ledangaravi/sync-module/CV/images/80.png

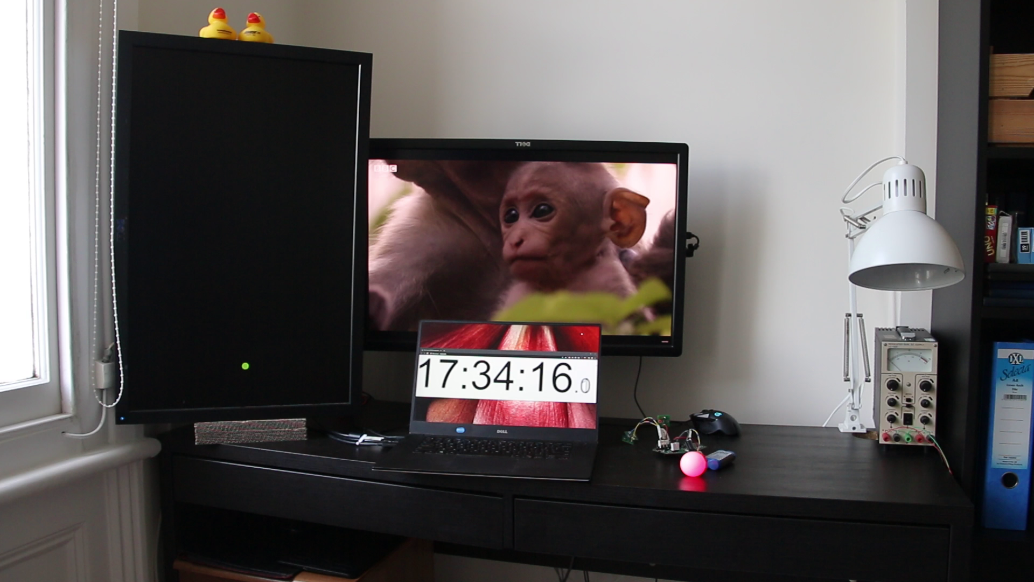
CV/images/80.png
