ledangaravi/sync-module/CV/images/keypoints.png

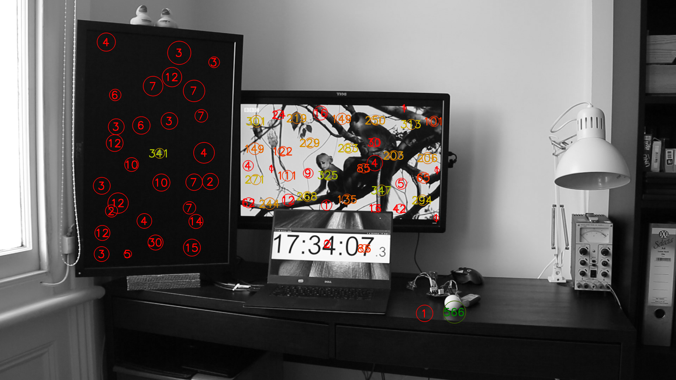
CV/images/keypoints.png
