ledangaravi/sync-module/README.md

# sync-module
Synchronisation Module for the NGNI Spike Sorting Platform
