ledangaravi/sync-module/CV/morph_demo/closeopen.png

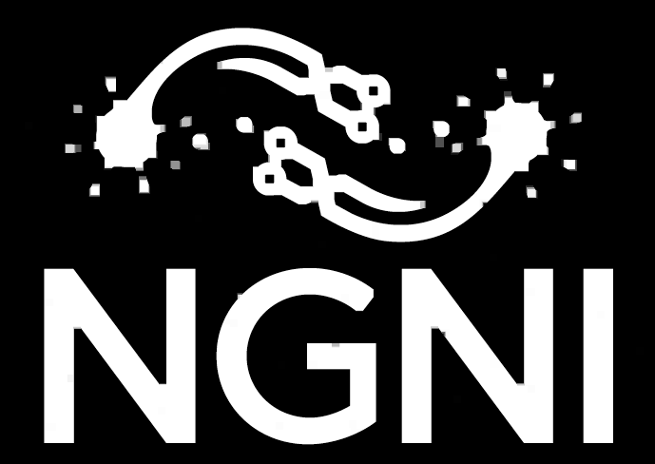
CV/morph_demo/closeopen.png
