ledangaravi/sync-module/CV/morph_demo/closing1.png

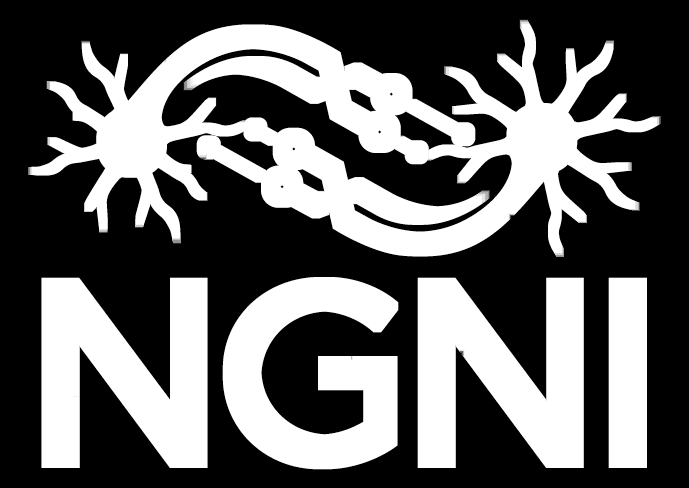
CV/morph_demo/closing1.png
