ledangaravi/sync-module/CV/morph_demo/closing2.png

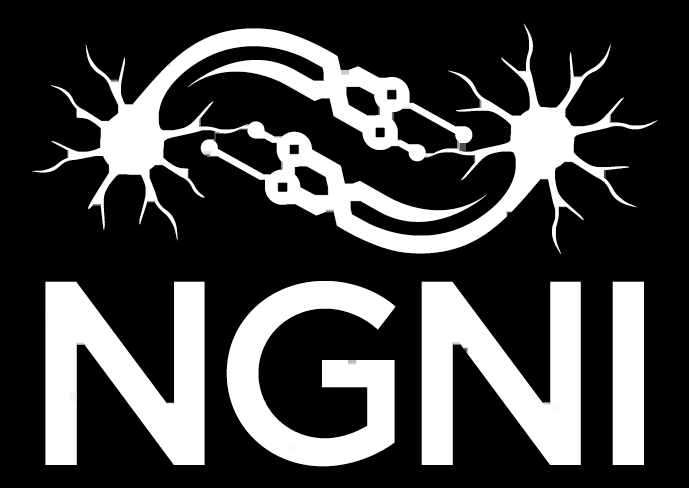
CV/morph_demo/closing2.png
