ledangaravi/sync-module/CV/morph_demo/erosion.png

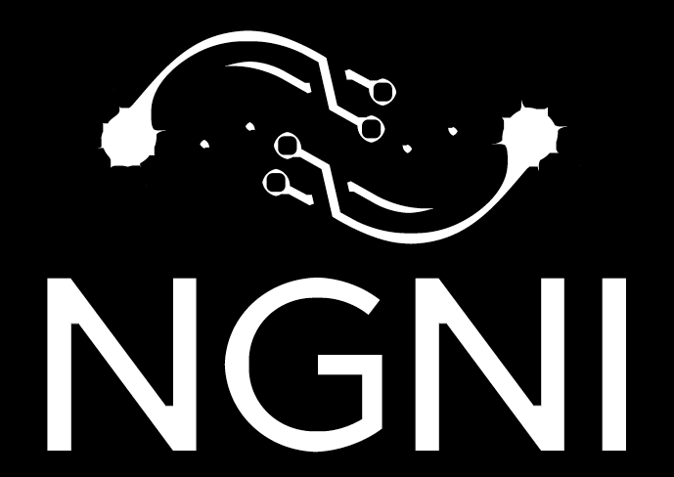
CV/morph_demo/erosion.png
