ledangaravi/sync-module/beacon_enclosure/case.stl

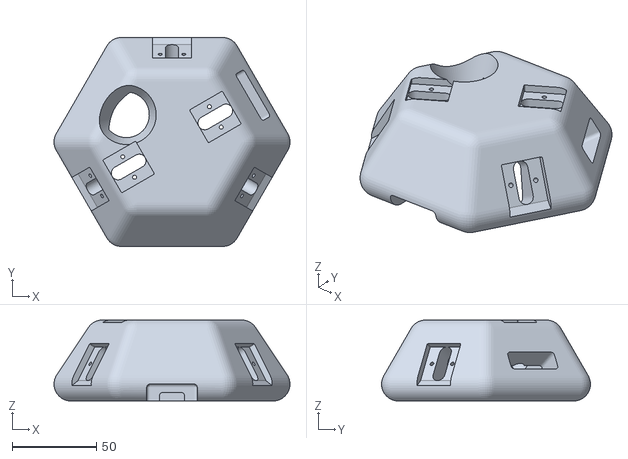
[picture p7: CAD file, 2020-06-19]
beacon_enclosure/case.stl
139.9 x 123.9 x 48.0
