ledangaravi/sync-module/PCB/KiCad_Library/my_library/3D_models/USB_C_Receptacle_HIROSE_CX90M-16P.stp

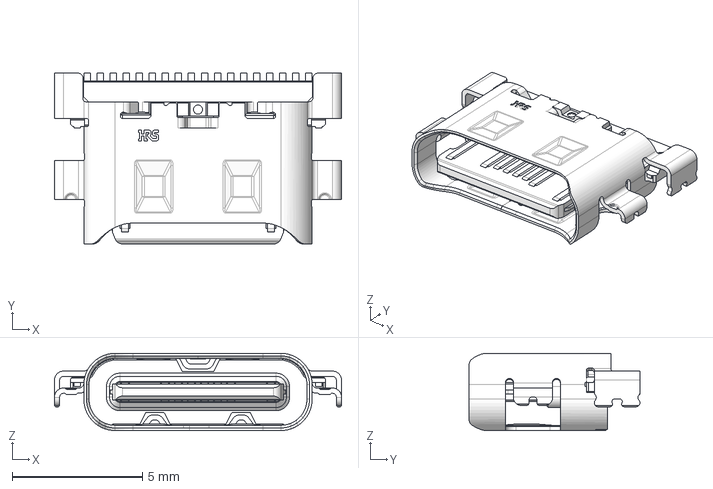
[picture p8: CAD file, 2020-06-19]
PCB/KiCad_Library/my_library/3D_models/USB_C_Receptacle_HIROSE_CX90M-16P.stp
11.0 x 6.55 x 2.97 mm
