ledangaravi/sync-module/Testing/power_consumption/battery_life_cam_max.pdf

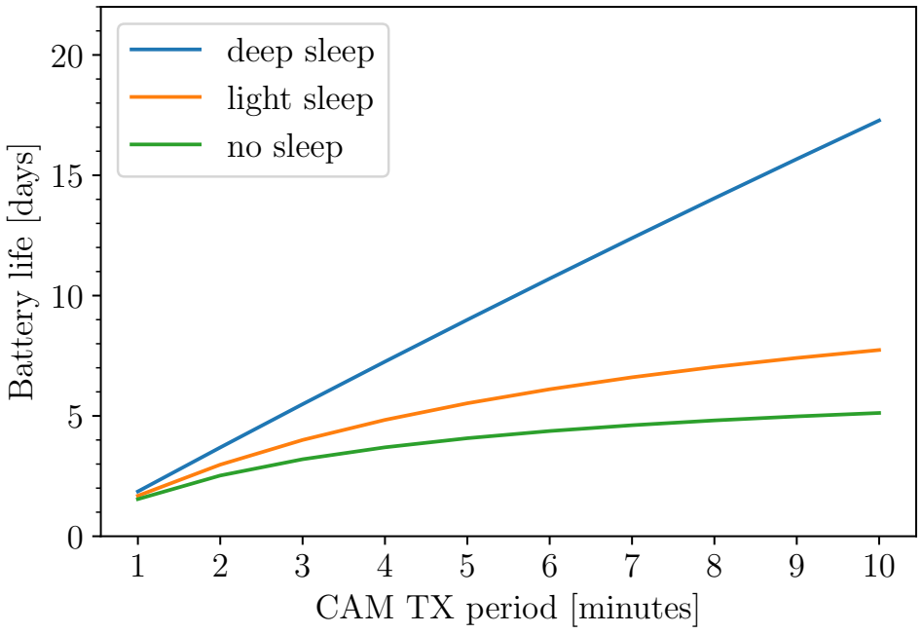
[picture p9: figure]
CAM TX period [minutes]; Battery life [days]; deep sleep light sleep no sleep
