ledangaravi/sync-module/Testing/power_consumption/battery_life_cam_mid.pdf

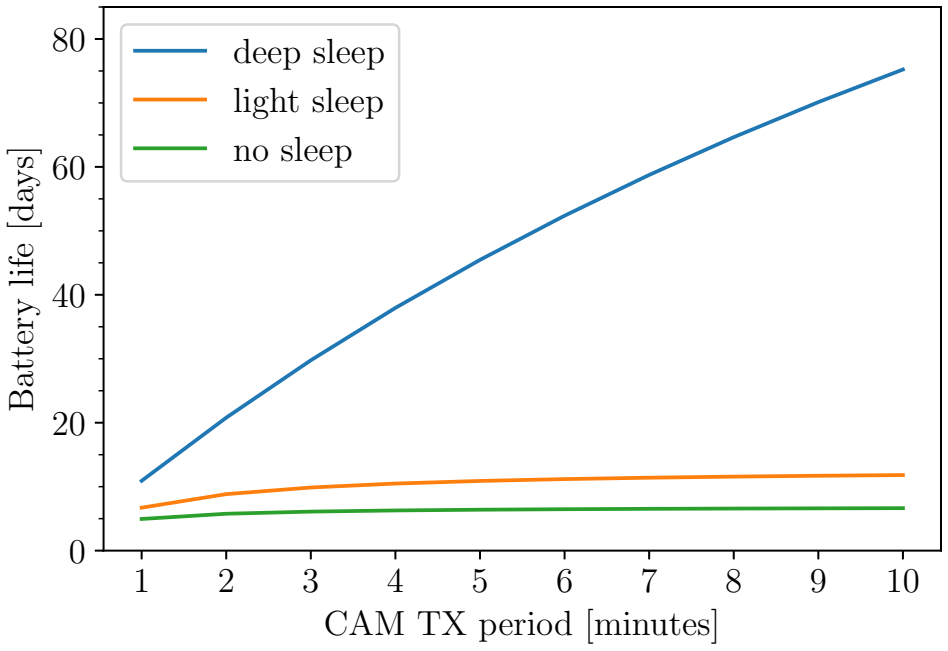
[picture p10: figure]
CAM TX period [minutes]; Battery life [days]; deep sleep light sleep no sleep
