ledangaravi/sync-module/Testing/webench/lm3478.pdf

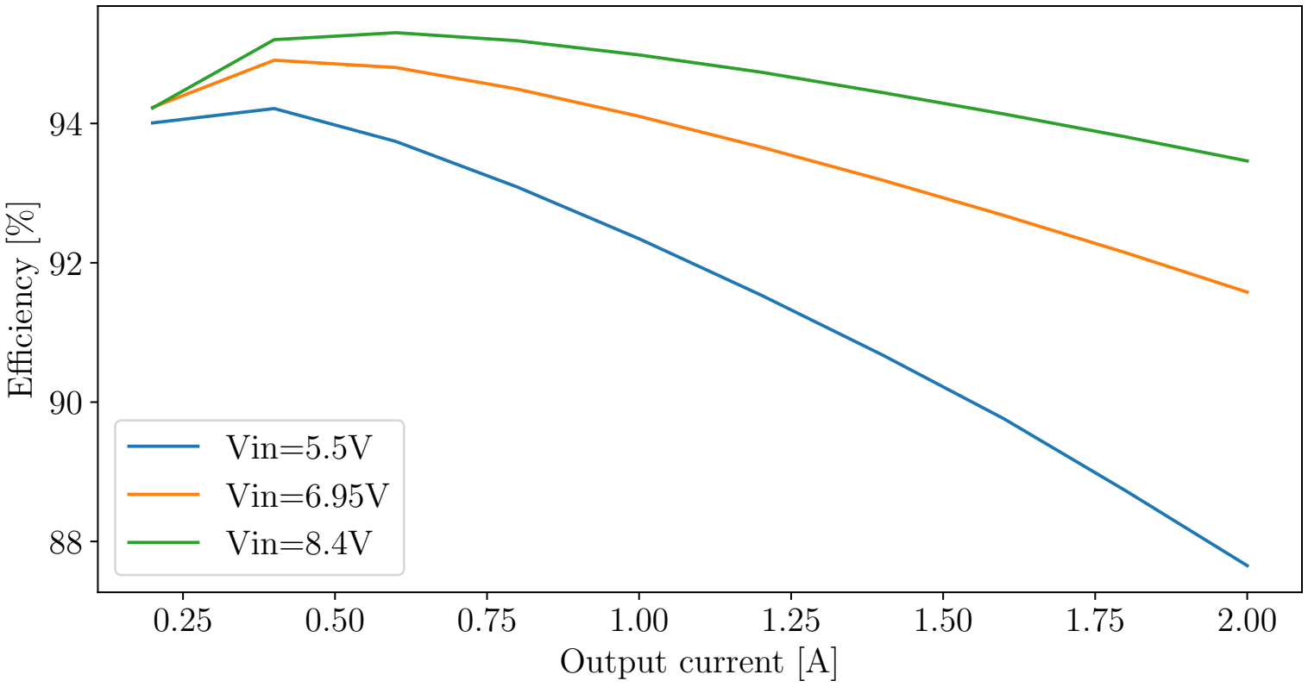
[picture p11: figure]
Output current [A]; Efficiency [%]; Vin=5.5V Vin=6.95V Vin=8.4V
