ledangaravi/sync-module/Testing/webench/lm3478.csv

Output Current | Vin=5.5V | Vin=6.95V | Vin=8.4V
0.2 | 94.008 | 94.231 | 94.222
0.4 | 94.214 | 94.908 | 95.203
0.6000000000000001 | 93.742 | 94.803 | 95.303
0.8 | 93.087 | 94.493 | 95.187
1 | 92.345 | 94.103 | 94.984
1.2 | 91.539 | 93.662 | 94.737
1.4 | 90.678 | 93.187 | 94.444
1.5999999999999999 | 89.761 | 92.68 | 94.136
1.7999999999999998 | 88.729 | 92.145 | 93.808
1.9999999999999998 | 87.653 | 91.579 | 93.462
