ledangaravi/sync-module/Testing/power_consumption/led_energy.pdf

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

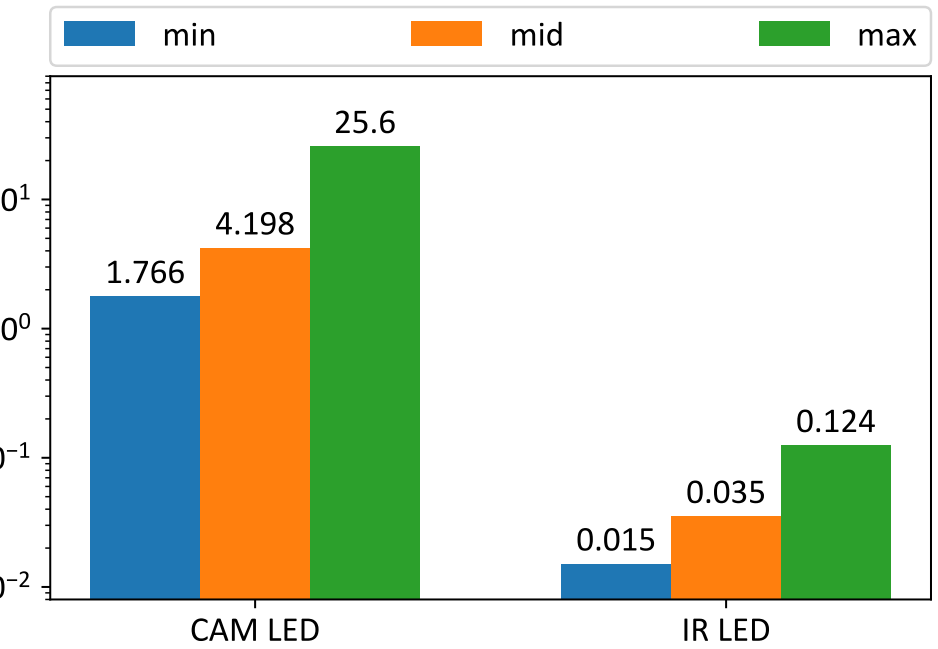
[picture p12: figure]
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
