ledangaravi/sync-module/Testing/webench/tlv62130.csv

Output Current | Vin=5.5V | Vin=6.95V | Vin=8.4V
0.001 | 87.709 | 86.236 | 84.455
0.0015 | 88.688 | 87.406 | 85.792
0.002 | 89.186 | 88.003 | 86.476
0.0025 | 89.487 | 88.365 | 86.892
0.003 | 89.689 | 88.608 | 87.171
0.0035 | 89.833 | 88.782 | 87.371
0.004 | 89.942 | 88.913 | 87.522
0.0045 | 90.027 | 89.015 | 87.64
0.005 | 90.095 | 89.097 | 87.734
0.0055 | 90.15 | 89.164 | 87.812
0.006 | 90.196 | 89.22 | 87.876
0.0065 | 90.235 | 89.267 | 87.931
0.007 | 90.269 | 89.308 | 87.978
0.0075 | 90.298 | 89.343 | 88.018
0.008 | 90.323 | 89.374 | 88.054
0.0085 | 90.346 | 89.401 | 88.085
0.009 | 90.365 | 89.425 | 88.113
0.0095 | 90.383 | 89.446 | 88.138
0.01 | 90.399 | 89.466 | 88.16
0.015 | 90.499 | 89.588 | 88.302
0.02 | 90.547 | 89.648 | 88.371
0.025 | 90.575 | 89.683 | 88.412
0.03 | 90.593 | 89.705 | 88.439
0.035 | 90.604 | 89.72 | 88.457
0.04 | 90.612 | 89.731 | 88.471
0.045 | 90.618 | 89.739 | 88.48
0.05 | 90.621 | 89.745 | 88.488
0.055 | 90.624 | 89.75 | 88.493
0.06 | 90.625 | 89.753 | 88.497
0.065 | 90.626 | 89.755 | 88.501
0.07 | 90.626 | 89.757 | 88.503
0.075 | 90.626 | 89.758 | 88.505
0.08 | 90.626 | 89.758 | 88.506
0.085 | 90.625 | 89.759 | 88.507
0.09 | 90.624 | 89.759 | 88.508
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
