ledangaravi/sync-module/Testing/power_consumption/data/8V/1 - ir led max (0.5ohm)/F0001CH1.CSV

Record Length | 2.500000e+03 | -0.005000000000 | 0.00800
Sample Interval | 4.000000e-06 | -0.004996000000 | 0.00800
Trigger Point | 1.250000000000e+03 | -0.004992000000 | 0.00800
 |  | -0.004988000000 | 0.00800
 |  | -0.004984000000 | 0.00800
 |  | -0.004980000000 | 0.00000
Source | CH1 | -0.004976000000 | 0.00800
Vertical Units | V | -0.004972000000 | 0.00800
Vertical Scale | 2.000000e-01 | -0.004968000000 | 0.00800
Vertical Offset | -6.240000e-01 | -0.004964000000 | 0.01600
Horizontal Units | s | -0.004960000000 | 0.00800
Horizontal Scale | 1.000000e-03 | -0.004956000000 | 0.01600
Pt Fmt | Y | -0.004952000000 | 0.00800
Yzero | 0.000000e+00 | -0.004948000000 | 0.00800
Probe Atten | 1.000000e+00 | -0.004944000000 | 0.00800
Model Number | TDS2012C | -0.004940000000 | 0.00800
Serial Number | C023721 | -0.004936000000 | 0.00800
Firmware Version | FV:v24.18 | -0.004932000000 | 0.00000
 |  | -00.004928000000 | 0.00800
 |  | -00.004924000000 | 0.00800
 |  | -00.004920000000 | 0.00800
 |  | -00.004916000000 | 0.01600
 |  | -00.004912000000 | 0.01600
 |  | -00.004908000000 | 0.01600
 |  | -00.004904000000 | 0.00800
 |  | -00.004900000000 | 0.00800
 |  | -00.004896000000 | 0.00800
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
