ledangaravi/sync-module/Testing/power_consumption/data/8V/2 - ir led mid (0.5ohm)/F0002CH1.CSV

Record Length | 2.500000e+03 | -0.025000000000 | 0.00800
Sample Interval | 2.000000e-05 | -0.024980000000 | 0.00800
Trigger Point | 1.250000000000e+03 | -0.024960000000 | 0.00800
 |  | -0.024940000000 | 0.00800
 |  | -0.024920000000 | 0.00800
 |  | -0.024900000000 | 0.00800
Source | CH1 | -0.024880000000 | 0.00800
Vertical Units | V | -0.024860000000 | 0.00800
Vertical Scale | 2.000000e-01 | -0.024840000000 | 0.00800
Vertical Offset | -6.240000e-01 | -0.024820000000 | 0.01600
Horizontal Units | s | -0.024800000000 | 0.00800
Horizontal Scale | 5.000000e-03 | -0.024780000000 | 0.01600
Pt Fmt | Y | -0.024760000000 | 0.00800
Yzero | 0.000000e+00 | -0.024740000000 | 0.00800
Probe Atten | 1.000000e+00 | -0.024720000000 | 0.00800
Model Number | TDS2012C | -0.024700000000 | 0.00800
Serial Number | C023721 | -0.024680000000 | 0.01600
Firmware Version | FV:v24.18 | -0.024660000000 | 0.00800
 |  | -00.024640000000 | 0.00800
 |  | -00.024620000000 | 0.00800
 |  | -00.024600000000 | 0.24000
 |  | -00.024580000000 | 0.67200
 |  | -00.024560000000 | 0.73600
 |  | -00.024540000000 | 0.69600
 |  | -00.024520000000 | 0.68000
 |  | -00.024500000000 | 0.67200
 |  | -00.024480000000 | 0.60800
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
