ledangaravi/sync-module/Testing/power_consumption/data/8V/4 - cam led min (10ohm)/F0004CH1.CSV

Record Length | 2.500000e+03 | -0.250000000000 | 0.15200
Sample Interval | 2.000000e-04 | -0.249800000000 | 0.15000
Trigger Point | 1.250000000000e+03 | -0.249600000000 | 0.15000
 |  | -0.249400000000 | 0.15000
 |  | -0.249200000000 | 0.14800
 |  | -0.249000000000 | 0.14800
Source | CH1 | -0.248800000000 | 0.14800
Vertical Units | V | -0.248600000000 | 0.14600
Vertical Scale | 5.000000e-02 | -0.248400000000 | 0.14600
Vertical Offset | -1.560000e-01 | -0.248200000000 | 0.14400
Horizontal Units | s | -0.248000000000 | 0.14400
Horizontal Scale | 5.000000e-02 | -0.247800000000 | 0.14400
Pt Fmt | Y | -0.247600000000 | 0.14400
Yzero | 0.000000e+00 | -0.247400000000 | 0.14200
Probe Atten | 1.000000e+00 | -0.247200000000 | 0.14200
Model Number | TDS2012C | -0.247000000000 | 0.14200
Serial Number | C023721 | -0.246800000000 | 0.14200
Firmware Version | FV:v24.18 | -0.246600000000 | 0.14000
 |  | -00.246400000000 | 0.14000
 |  | -00.246200000000 | 0.13800
 |  | -00.246000000000 | 0.13800
 |  | -00.245800000000 | 0.14000
 |  | -00.245600000000 | 0.15600
 |  | -00.245400000000 | 0.15400
 |  | -00.245200000000 | 0.15400
 |  | -00.245000000000 | 0.15400
 |  | -00.244800000000 | 0.15200
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
