ledangaravi/sync-module/Testing/power_consumption/data/8V/5 - ir led min (10ohm)/F0005CH1.CSV

Record Length | 2.500000e+03 | -0.250000000000 | 0.18000
Sample Interval | 2.000000e-04 | -0.249800000000 | 0.18000
Trigger Point | 1.250000000000e+03 | -0.249600000000 | 0.18000
 |  | -0.249400000000 | 0.18000
 |  | -0.249200000000 | 0.16000
 |  | -0.249000000000 | 0.16000
Source | CH1 | -0.248800000000 | 0.26000
Vertical Units | V | -0.248600000000 | 1.80000
Vertical Scale | 5.000000e-01 | -0.248400000000 | 1.88000
Vertical Offset | -1.560000e+00 | -0.248200000000 | 1.94000
Horizontal Units | s | -0.248000000000 | 1.56000
Horizontal Scale | 5.000000e-02 | -0.247800000000 | 1.08000
Pt Fmt | Y | -0.247600000000 | 0.78000
Yzero | 0.000000e+00 | -0.247400000000 | 0.58000
Probe Atten | 1.000000e+00 | -0.247200000000 | 0.44000
Model Number | TDS2012C | -0.247000000000 | 0.34000
Serial Number | C023721 | -0.246800000000 | 0.28000
Firmware Version | FV:v24.18 | -0.246600000000 | 0.24000
 |  | -00.246400000000 | 0.22000
 |  | -00.246200000000 | 0.20000
 |  | -00.246000000000 | 0.18000
 |  | -00.245800000000 | 0.20000
 |  | -00.245600000000 | 0.20000
 |  | -00.245400000000 | 0.18000
 |  | -00.245200000000 | 0.18000
 |  | -00.245000000000 | 0.18000
 |  | -00.244800000000 | 0.18000
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
