ledangaravi/sync-module/Testing/power_consumption/data/8V/0 - cam led max (0.5ohm)/F0000TEK.JPG

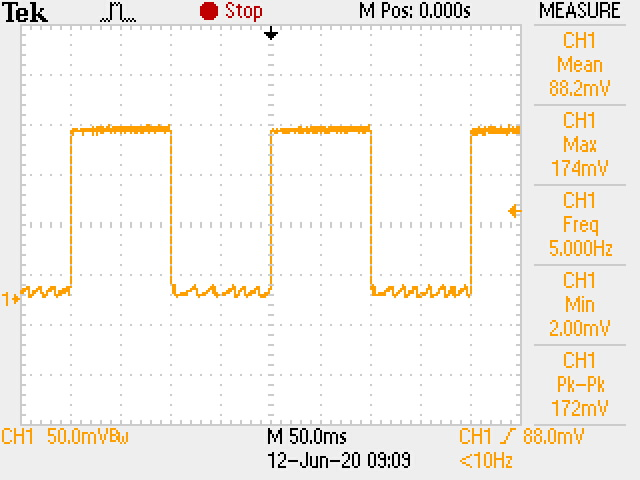
Testing/power_consumption/data/8V/0 - cam led max (0.5ohm)/F0000TEK.JPG
