ledangaravi/sync-module/Testing/power_consumption/data/8V/1 - ir led max (0.5ohm)/F0001TEK.JPG

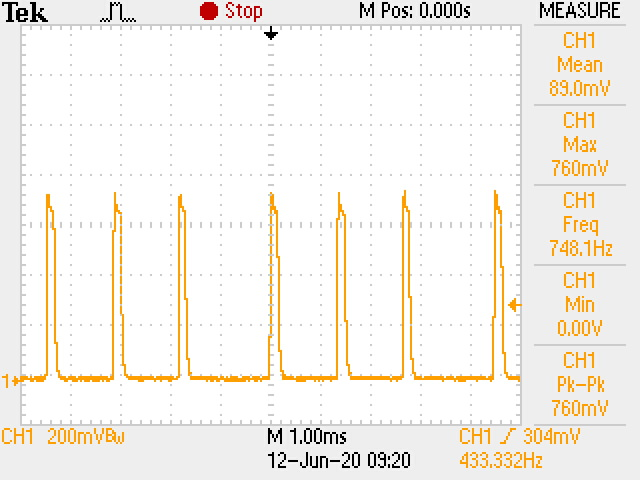
Testing/power_consumption/data/8V/1 - ir led max (0.5ohm)/F0001TEK.JPG
