ledangaravi/sync-module/Testing/power_consumption/data/8V/2 - ir led mid (0.5ohm)/F0002TEK.JPG

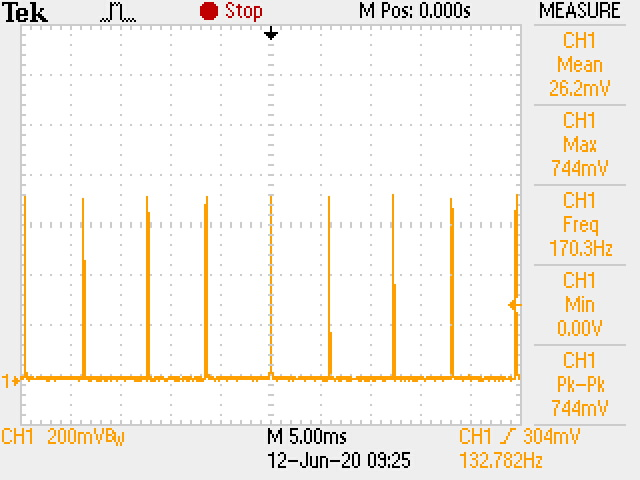
Testing/power_consumption/data/8V/2 - ir led mid (0.5ohm)/F0002TEK.JPG
