ledangaravi/sync-module/Testing/power_consumption/data/8V/3 - cam led mid (0.5ohm)/F0003TEK.JPG

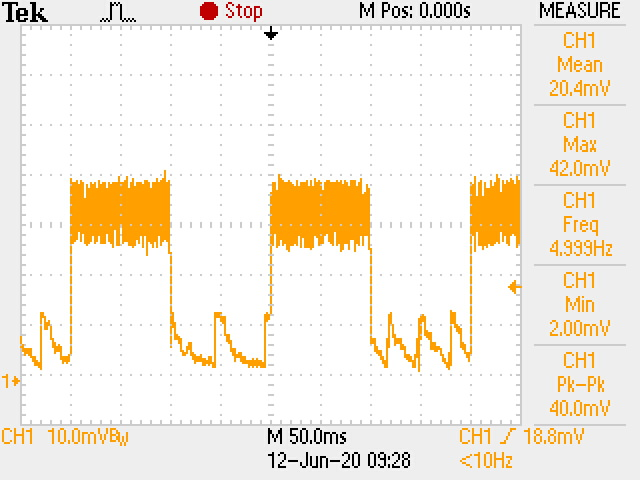
Testing/power_consumption/data/8V/3 - cam led mid (0.5ohm)/F0003TEK.JPG
