ledangaravi/sync-module/Testing/power_consumption/data/8V/4 - cam led min (10ohm)/F0004TEK.JPG

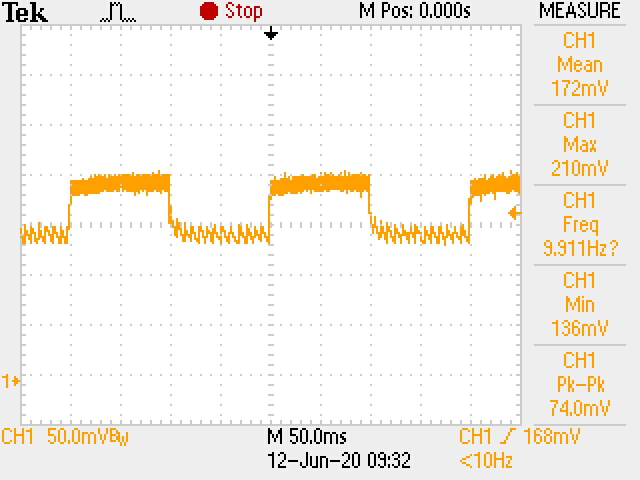
Testing/power_consumption/data/8V/4 - cam led min (10ohm)/F0004TEK.JPG
