ledangaravi/sync-module/Testing/power_consumption/data/8V/5 - ir led min (10ohm)/F0005TEK.JPG

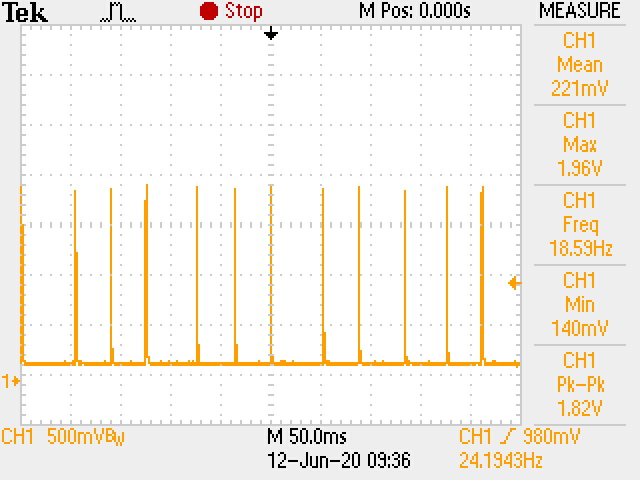
Testing/power_consumption/data/8V/5 - ir led min (10ohm)/F0005TEK.JPG
