ledangaravi/sync-module/Testing/power_consumption/data/8V/cam max (0.5)/F0000TEK.JPG

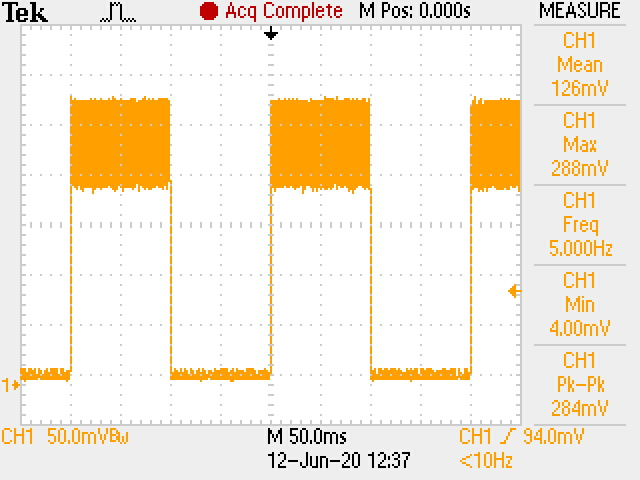
Testing/power_consumption/data/8V/cam max (0.5)/F0000TEK.JPG
