ledangaravi/sync-module/Testing/power_consumption/data/8V/deepsleep_3v3/F0000TEK.JPG

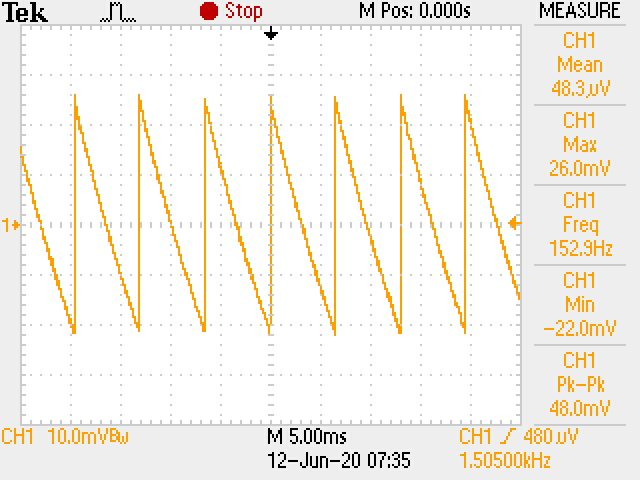
Testing/power_consumption/data/8V/deepsleep_3v3/F0000TEK.JPG
