ledangaravi/sync-module/Testing/power_consumption/data/8V/deepsleep_battery/F0000TEK.JPG

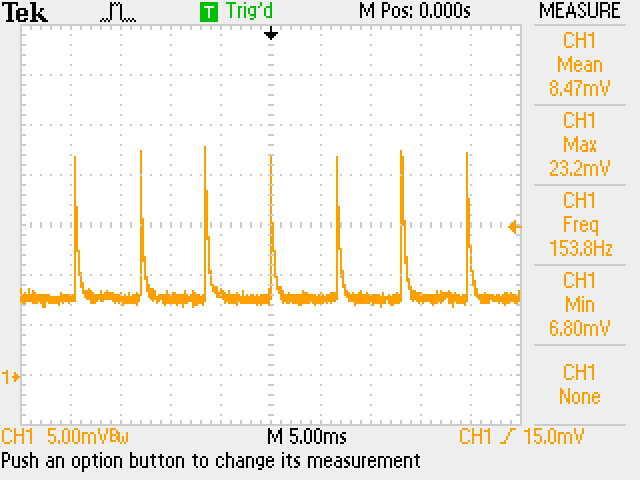
Testing/power_consumption/data/8V/deepsleep_battery/F0000TEK.JPG
