ledangaravi/sync-module/Testing/power_consumption/data/8V/delay_battery/F0000TEK.JPG

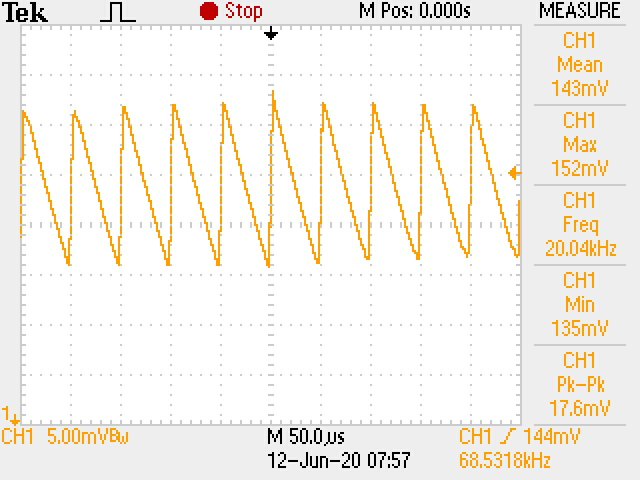
Testing/power_consumption/data/8V/delay_battery/F0000TEK.JPG
