ledangaravi/sync-module/Testing/power_consumption/data/8V/ir max (0.012)/F0001TEK.JPG

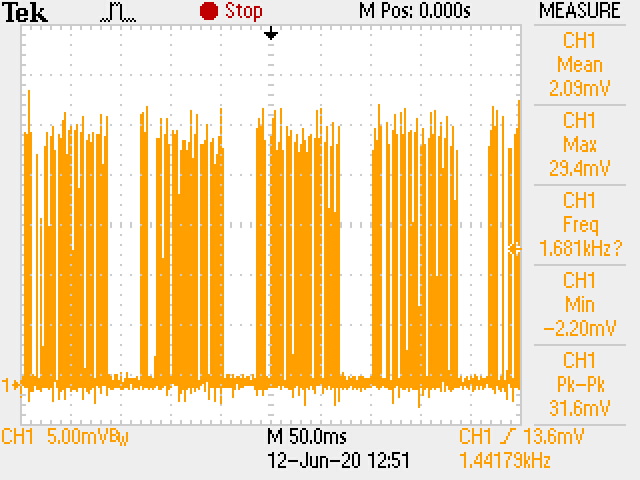
Testing/power_consumption/data/8V/ir max (0.012)/F0001TEK.JPG
