ledangaravi/sync-module/Testing/power_consumption/data/8V/ir max on (0.012)/F0002TEK.JPG

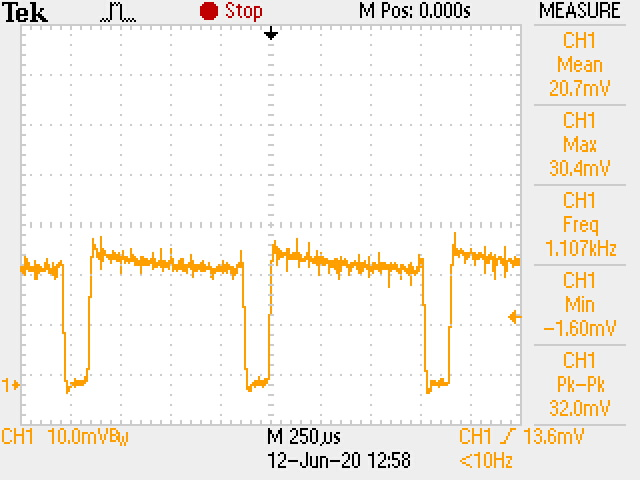
Testing/power_consumption/data/8V/ir max on (0.012)/F0002TEK.JPG
