ledangaravi/sync-module/Testing/power_consumption/data/8V/led turn on off/F0000TEK.JPG

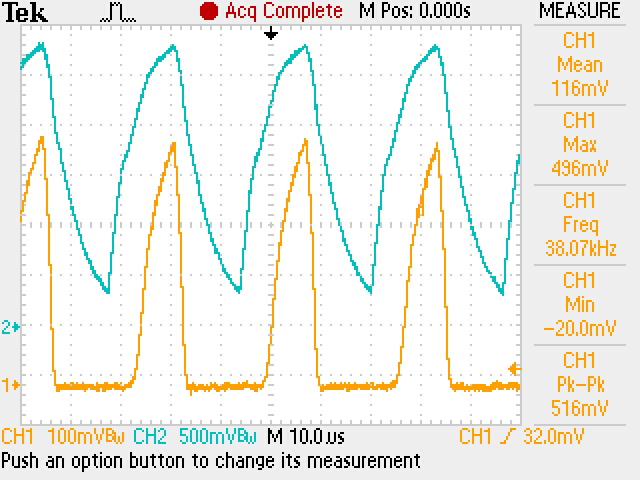
Testing/power_consumption/data/8V/led turn on off/F0000TEK.JPG
