ledangaravi/sync-module/Testing/power_consumption/data/8V/lightsleep_3v3/F0000TEK.JPG

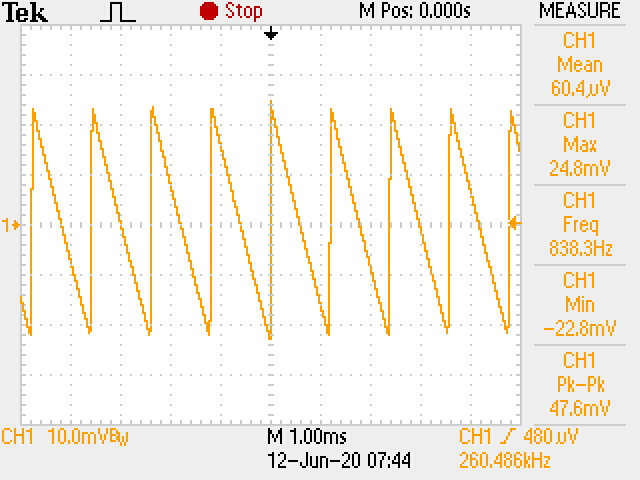
Testing/power_consumption/data/8V/lightsleep_3v3/F0000TEK.JPG
