ledangaravi/sync-module/Testing/power_consumption/data/8V/deep sleep battery (10ohm) fix/F0000TEK.JPG

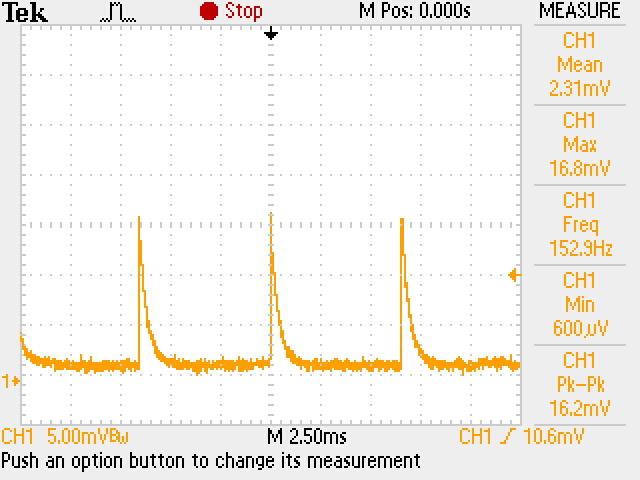
Testing/power_consumption/data/8V/deep sleep battery (10ohm) fix/F0000TEK.JPG
