ledangaravi/sync-module/Testing/power_consumption/data/8V/light sleep battery (10ohm) fix/F0001TEK.JPG

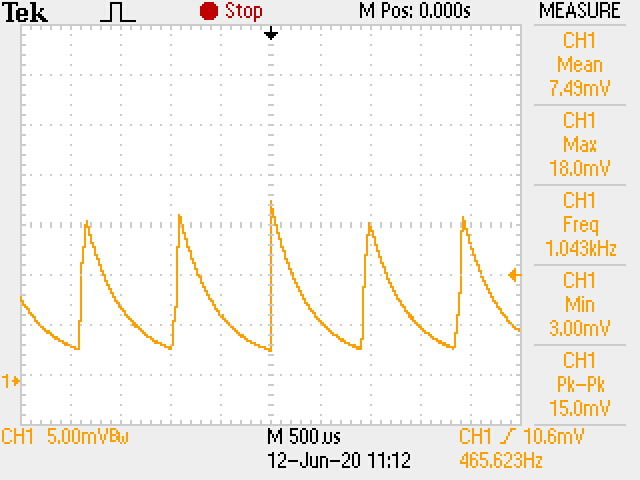
Testing/power_consumption/data/8V/light sleep battery (10ohm) fix/F0001TEK.JPG
