ledangaravi/sync-module/Testing/webench/tlv62130.pdf

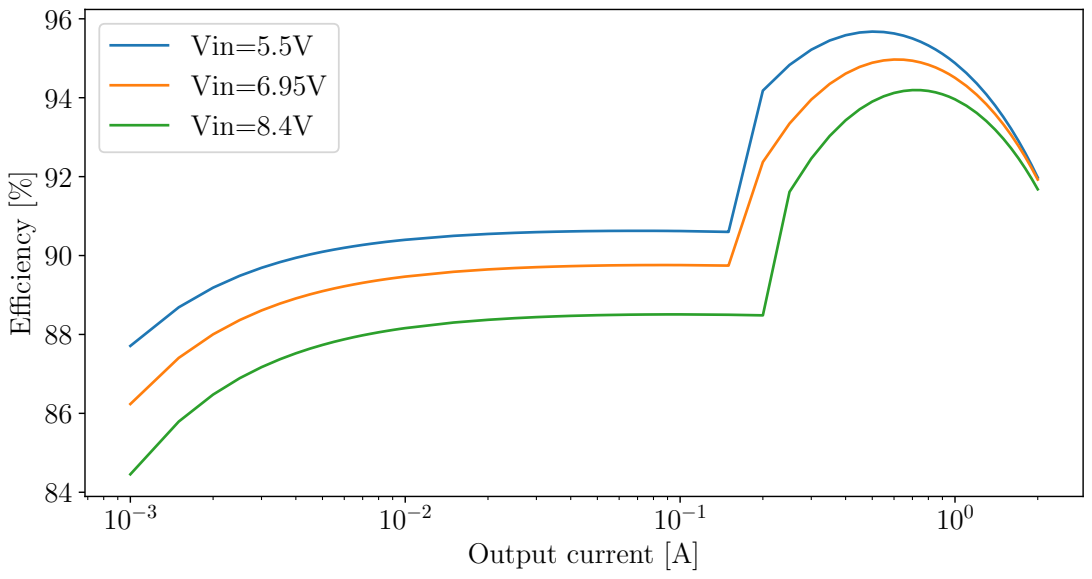
[picture p31: page 1]
Output current [A]; Efficiency [%]; Vin=5.5V Vin=6.95V Vin=8.4V
