ledangaravi/sync-module/PCB/sync_module/schematic/sync_module.pdf

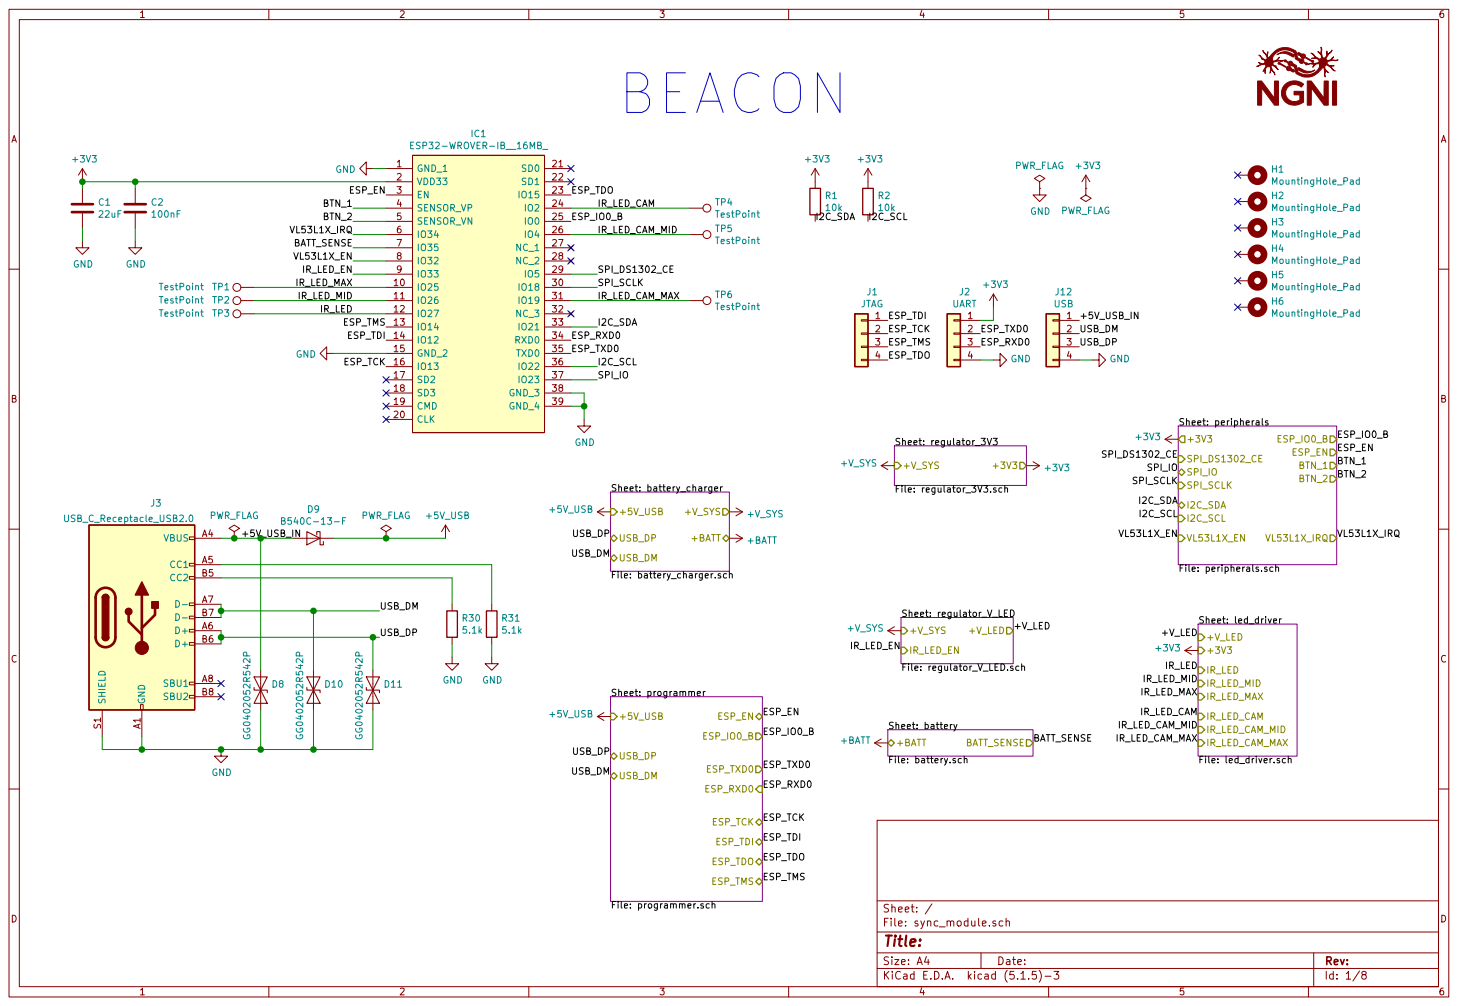
[picture p32: page 1]

File: sync_module.sch Sheet: / Sheet: battery_charger

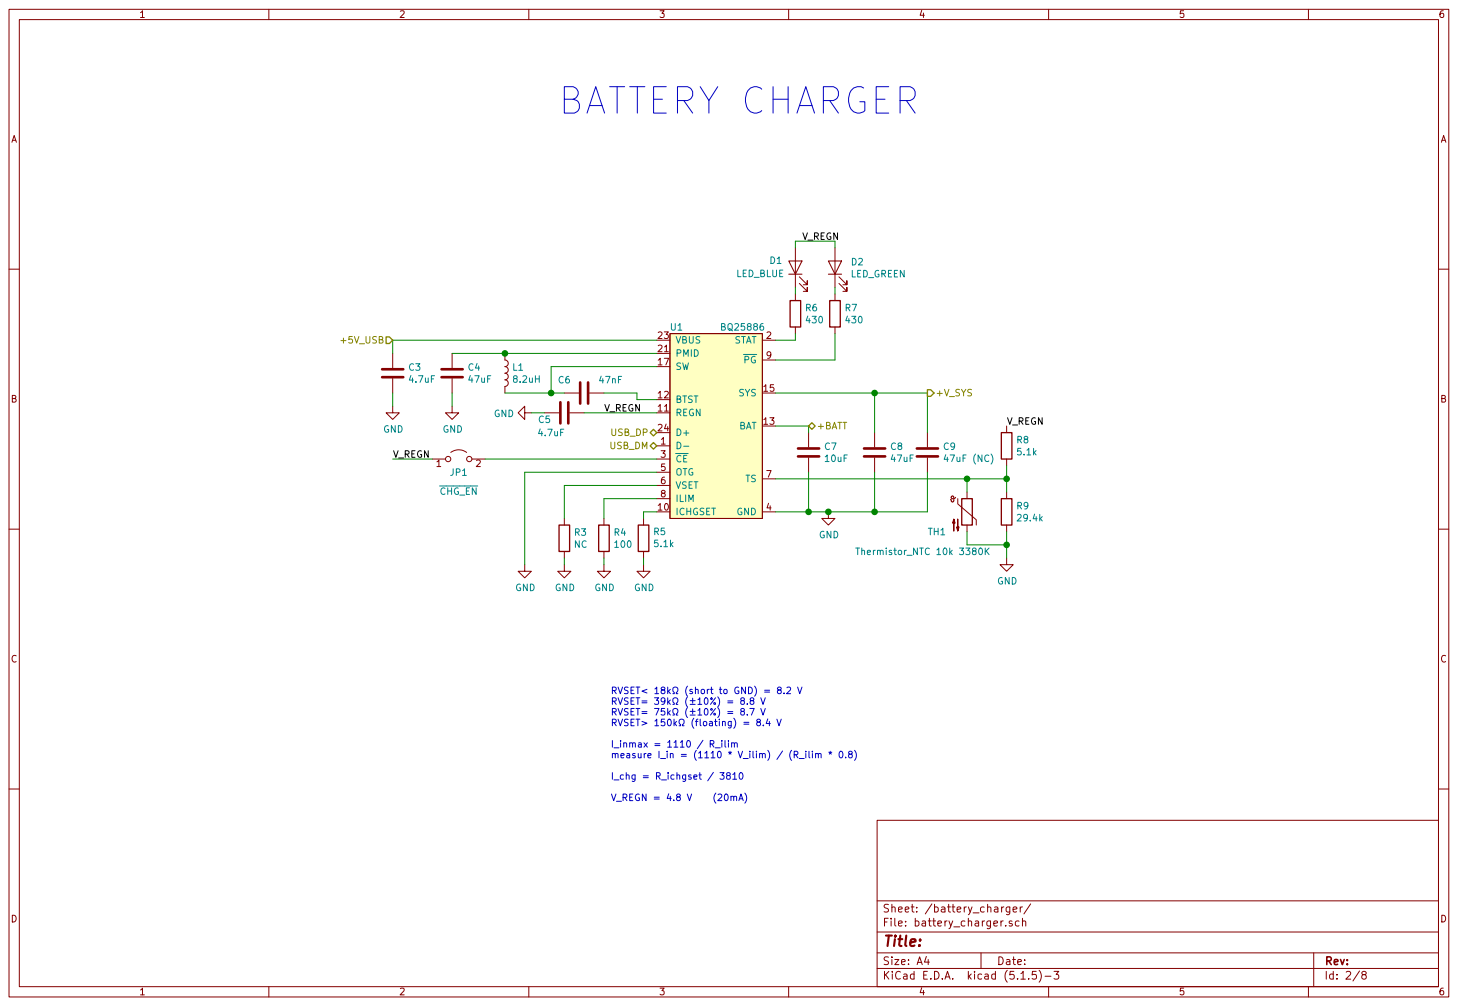
[picture p33: page 2]

RVSET< 18k (short to GND) = 8.2 V
RVSET= 39k (±10%) = 8.8 V
RVSET= 75k (±10%) = 8.7 V
RVSET> 150k (floating) = 8.4 V

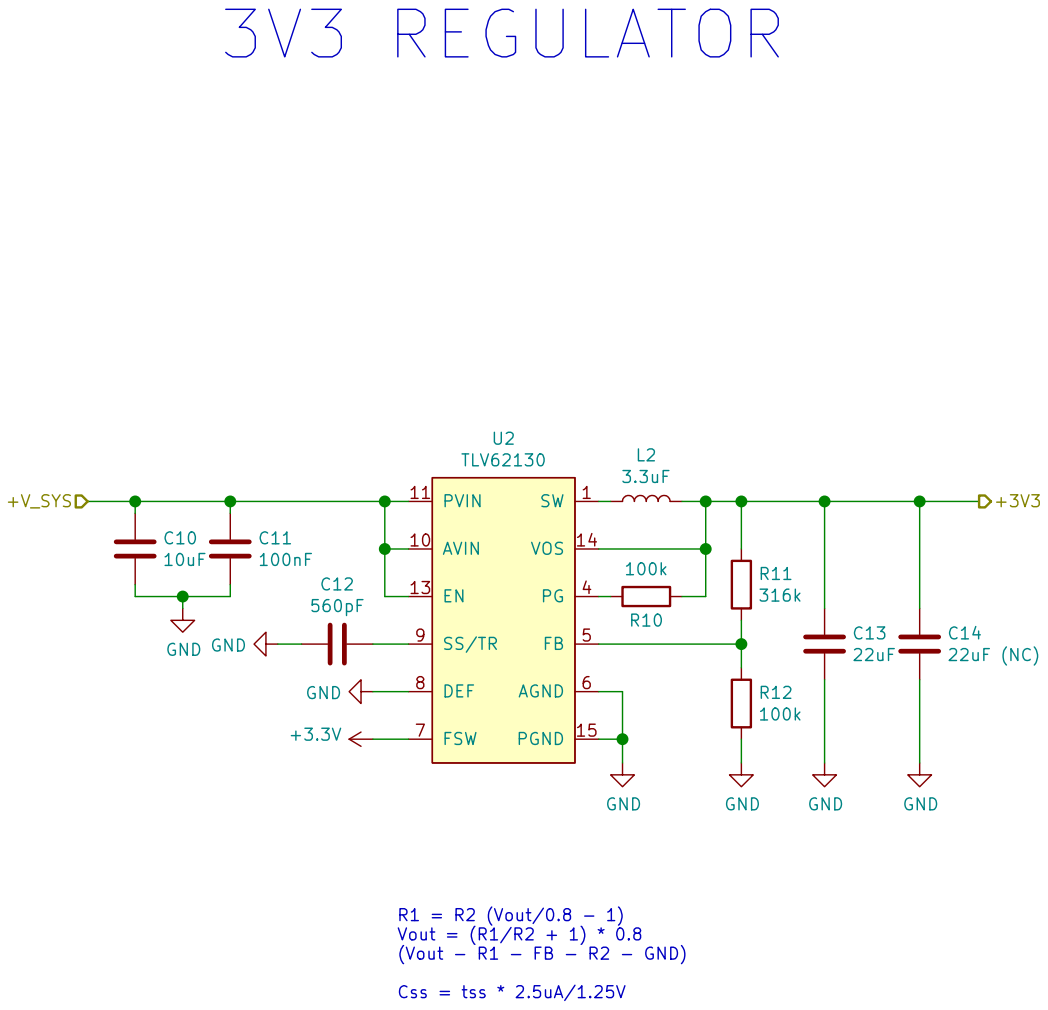
[picture p34: page 3]

R1 = R2 (Vout/0.8 - 1)
Vout = (R1/R2 + 1) * 0.8
(Vout - R1 - FB - R2 - GND) Css = tss * 2.5uA/1.25V

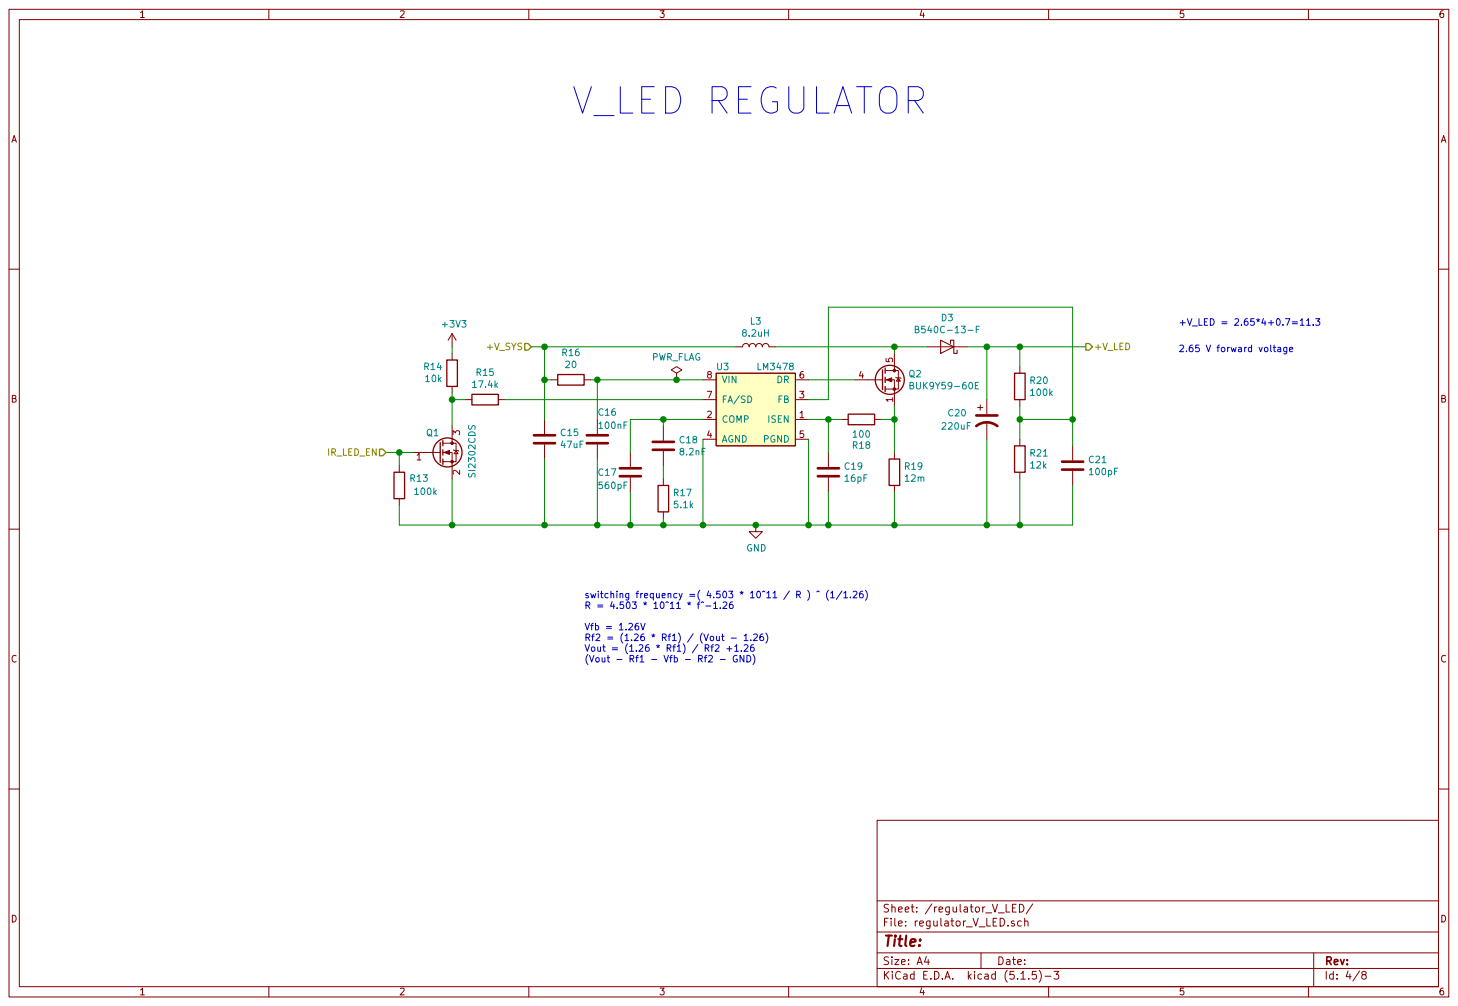
[picture p35: page 4]

switching frequency =( 4.503 * 10^11 / R ) ^ (1/1.26) R = 4.503 * 10^11 * f^-1.26 Vfb = 1.26V Rf2 = (1.26 * Rf1) / (Vout - 1.26)

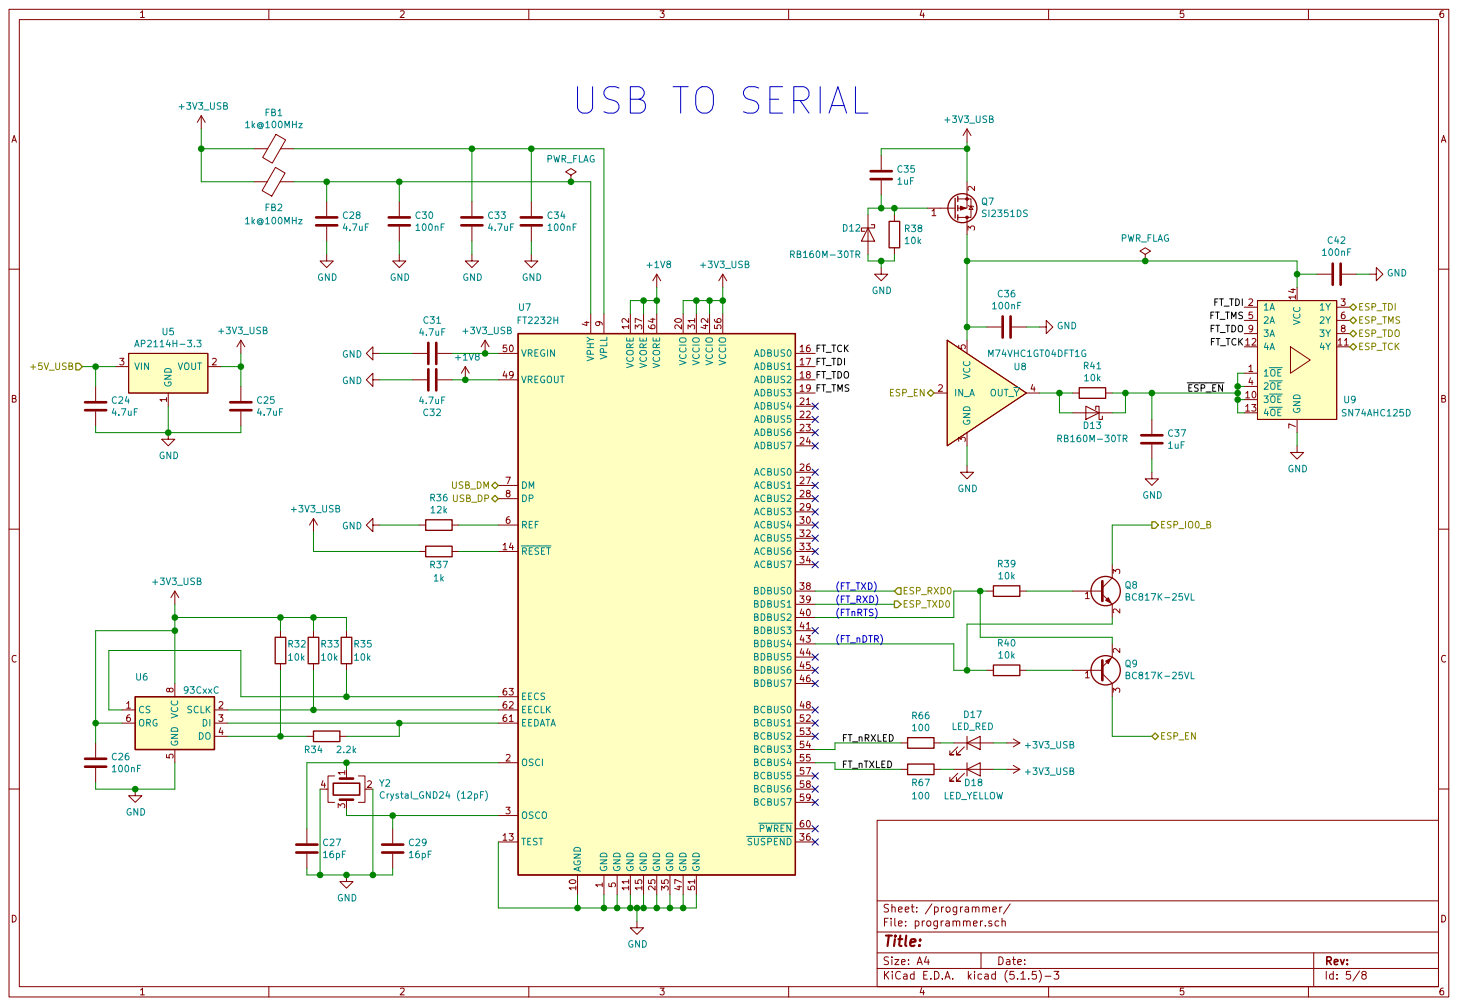
[picture p36: page 5]

1 VOUT 2 VIN 3 U5 AP2114H-3.3 GND GND

1 AGND 10 GND 11 VCORE 12 TEST 13 RESET 14 GND 15 ADBUS0 16 ADBUS1 17 ADBUS2 18 ADBUS3 19 OSCI 2 VCCIO 20 ADBUS4 21 ADBUS5 22 ADBUS6 23 ADBUS7 24 GND 25 ACBUS0 26 ACBUS1 27 ACBUS2 28 ACBUS3 29 OSCO 3 ACBUS4 30 VCCIO 31 ACBUS5 32 ACBUS6 33 ACBUS7 34 GND 35 SUSPEND 36 VCORE 37 BDBUS0 38 BDBUS1 39 VPHY

4 BDBUS2 40 BDBUS3 41 VCCIO 42 BDBUS4 43 BDBUS5 44 BDBUS6 45 BDBUS7 46 GND 47 BCBUS0 48 VREGOUT 49 GND

5 VREGIN 50 GND 51 BCBUS1 52 BCBUS2 53 BCBUS3 54 BCBUS4 55 VCCIO 56 BCBUS5 57 BCBUS6 58 BCBUS7 59 REF 6 PWREN 60 EEDATA 61 EECLK 62 EECS 63 VCORE 64 DM 7 DP 8 VPLL

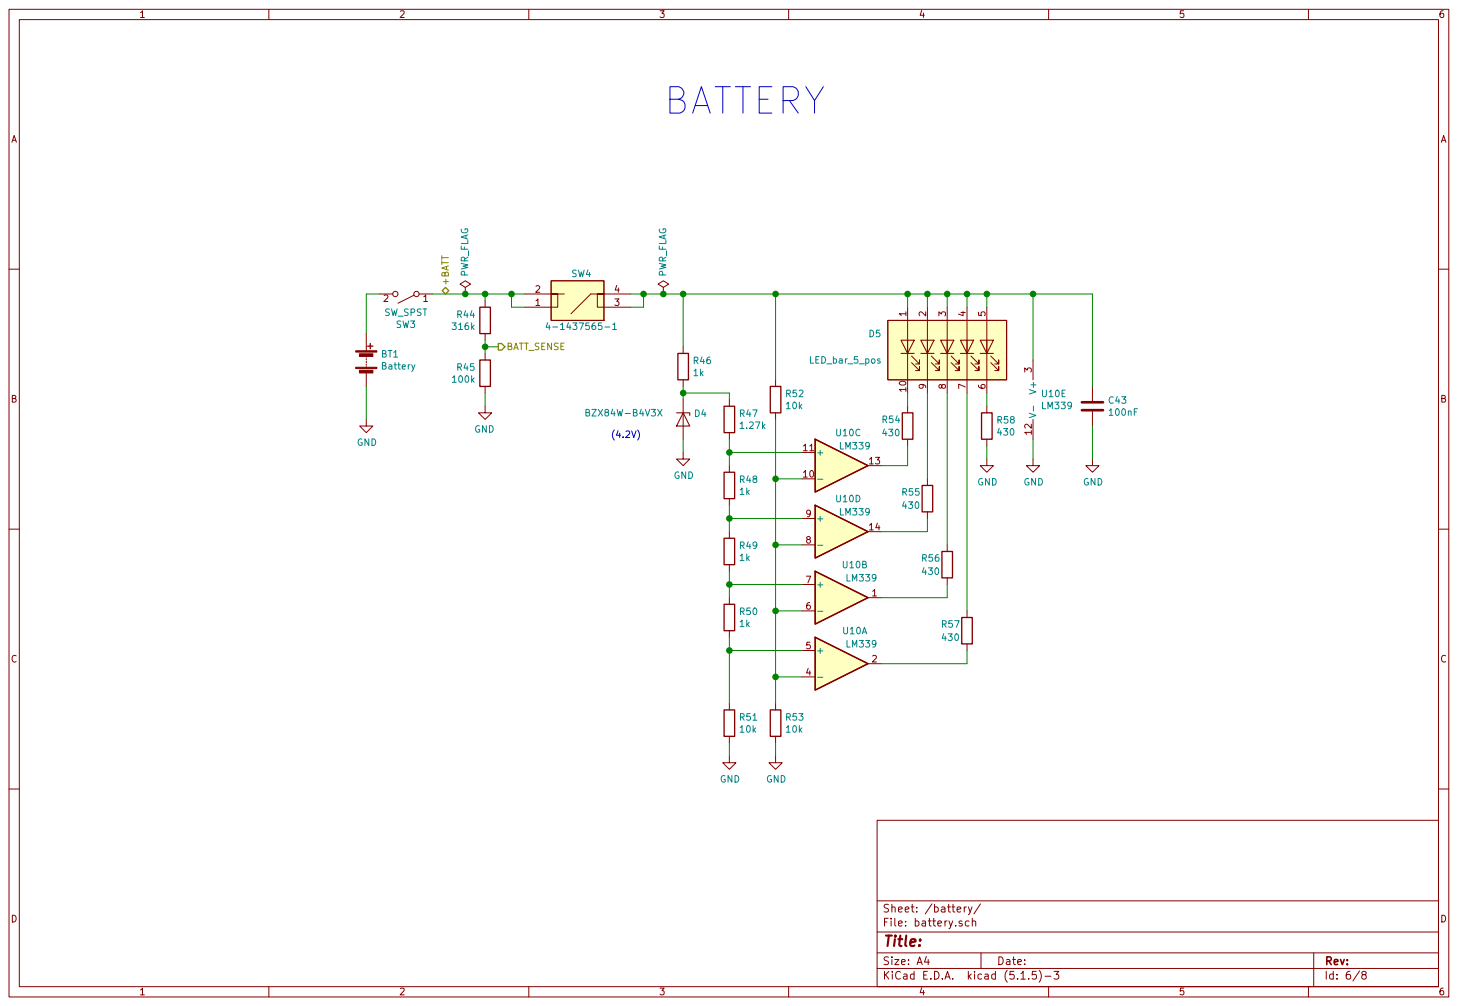
[picture p37: page 6]

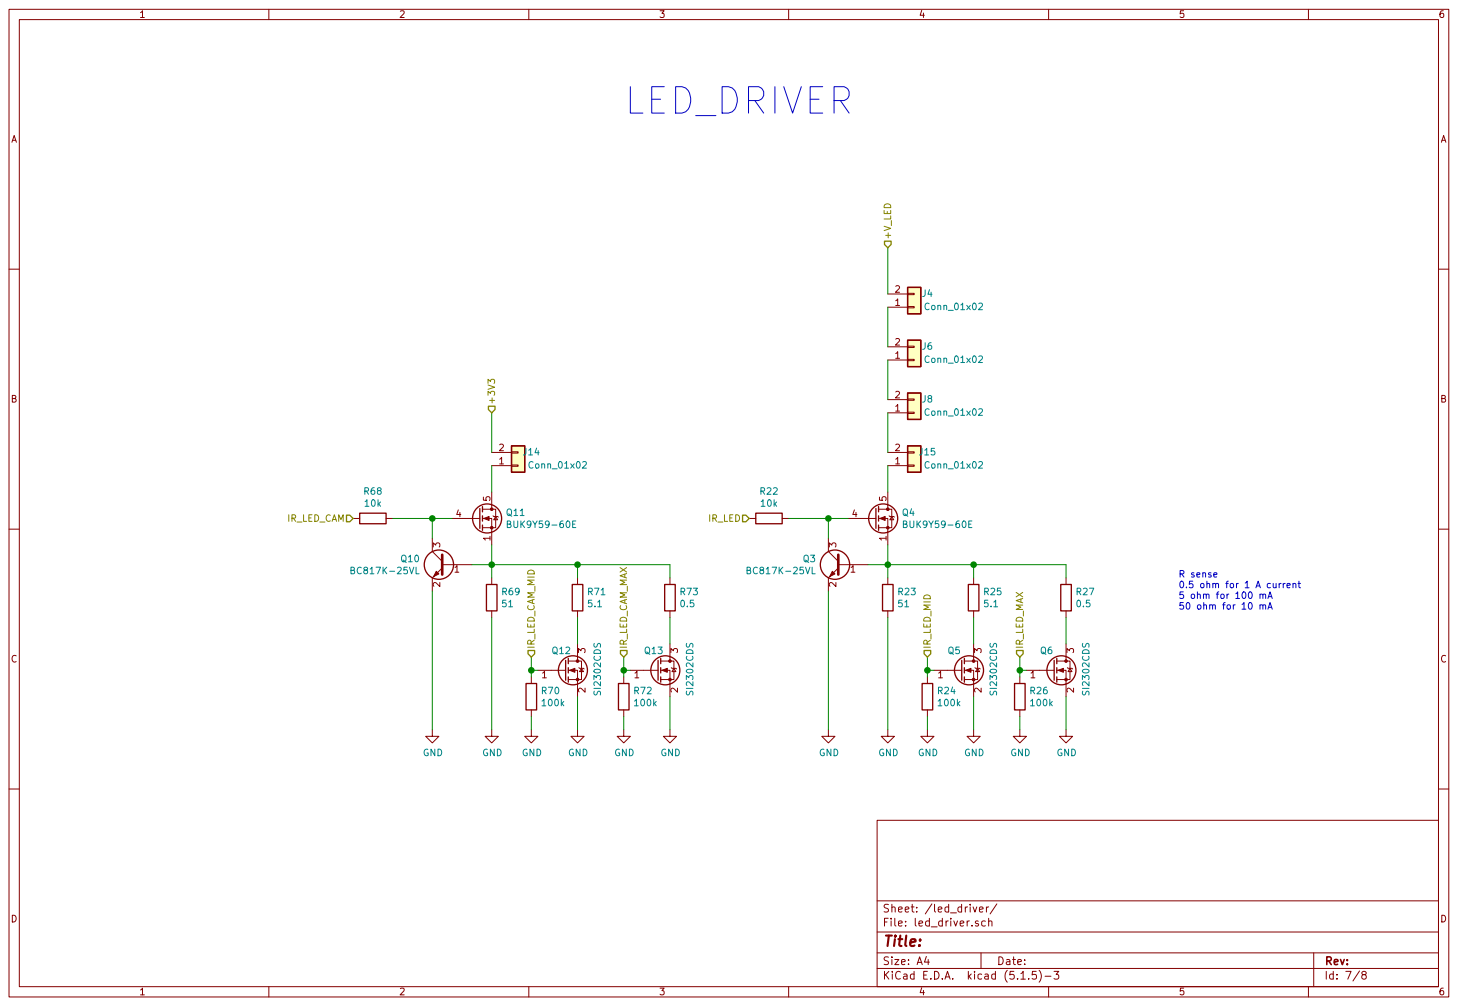
[picture p38: page 7]

0.5 ohm for 1 A current 5 ohm for 100 mA

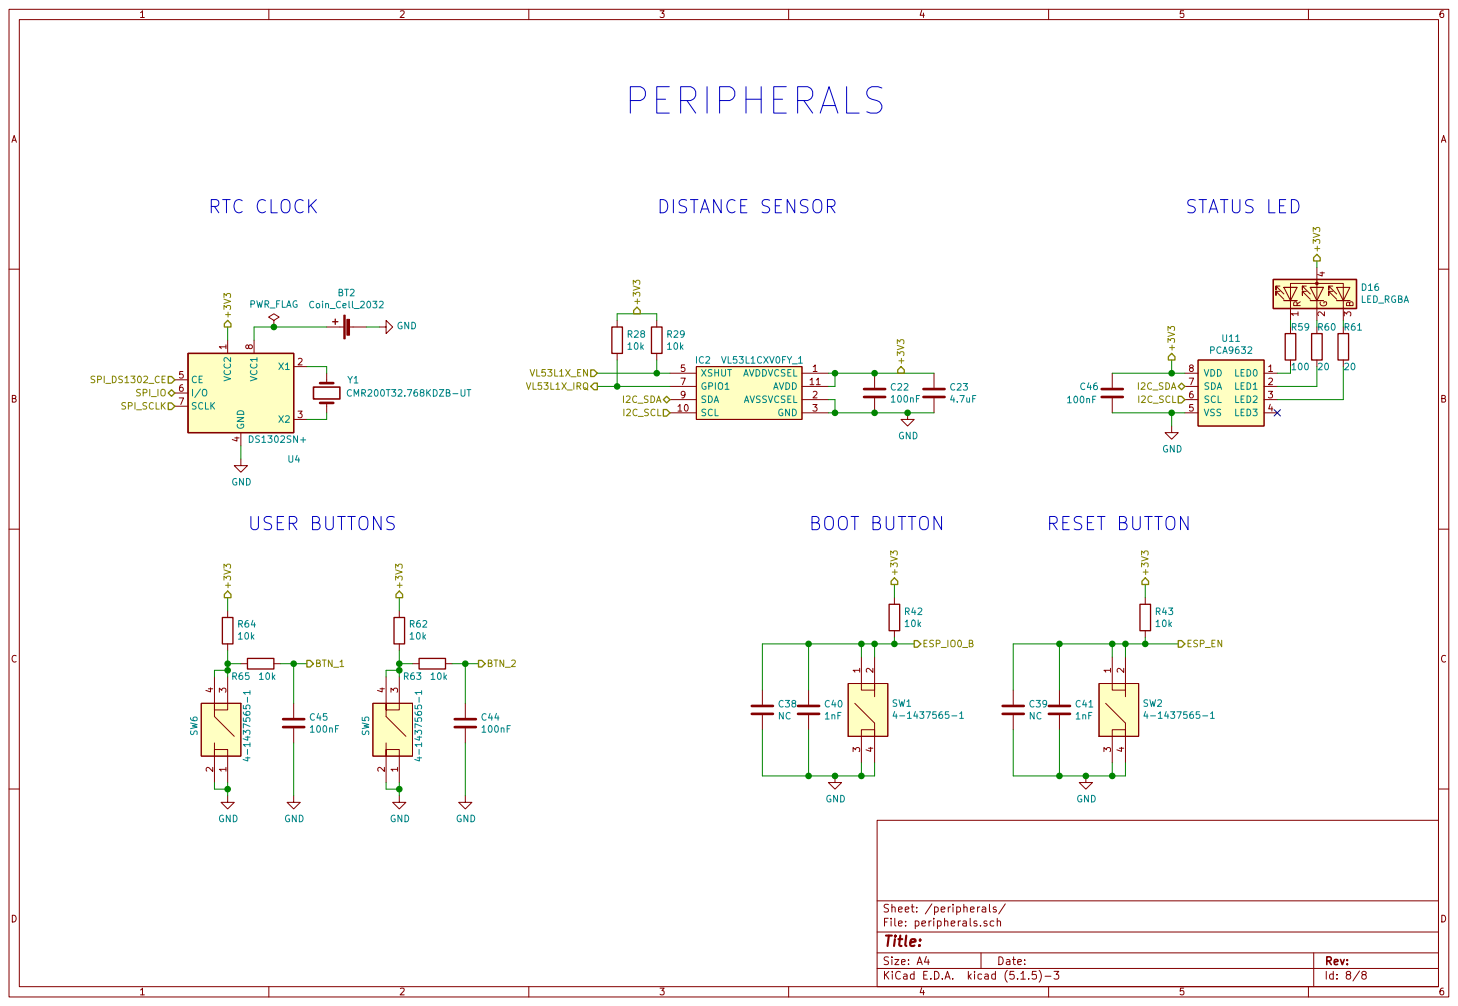
[picture p39: page 8]
