ledangaravi/sync-module/Testing/power_consumption/led_current.pdf

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

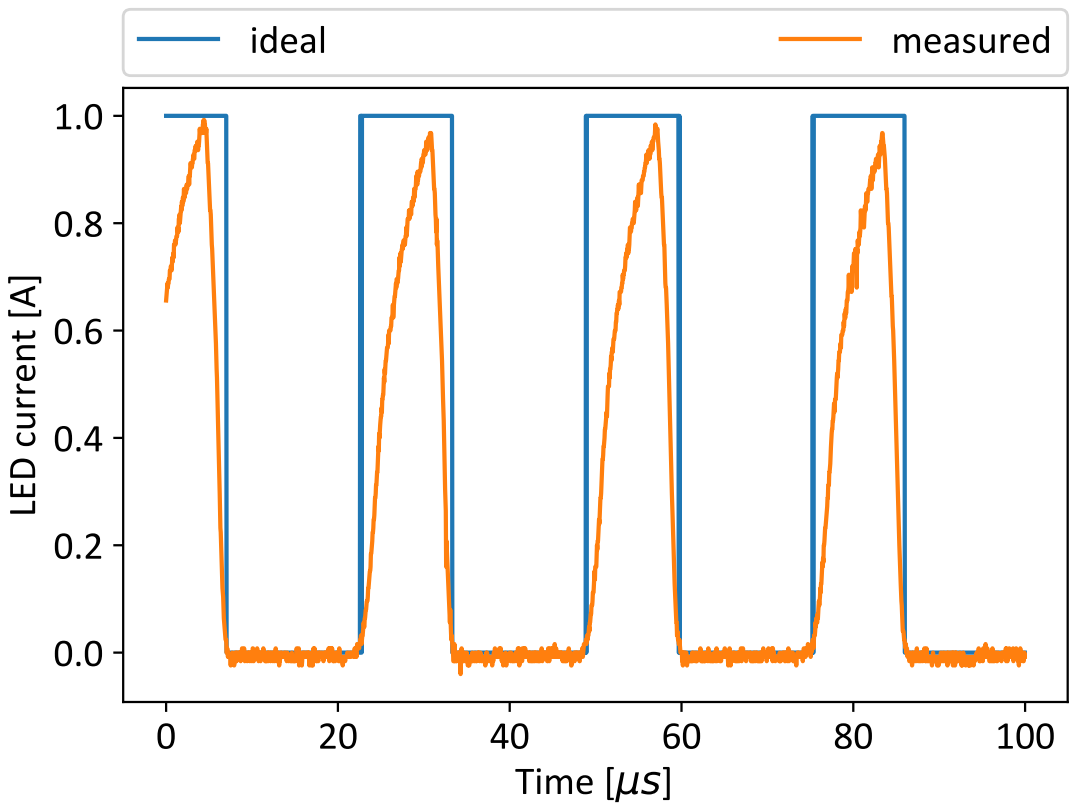
[picture p40: page 1]
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
