ledangaravi/sync-module/Testing/rx_test/rx_graphs/rx_indoors_10mA.pdf

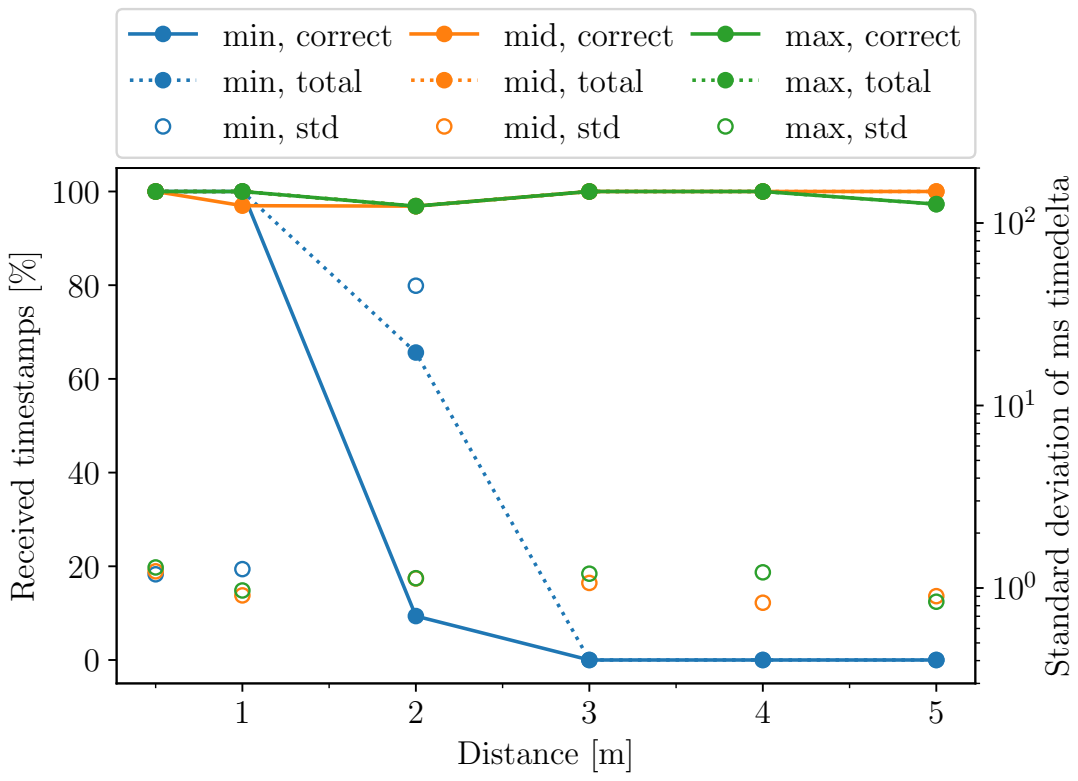
[picture p41: page 1]
Distance [m]; Received timestamps [%]; min, correct min, total min, std; mid, correct mid, total mid, std; max, correct max, total max, std

Standard deviation of ms timedelta
