ledangaravi/sync-module/Testing/rx_test/rx_graphs/rx_indoors_std_0.pdf

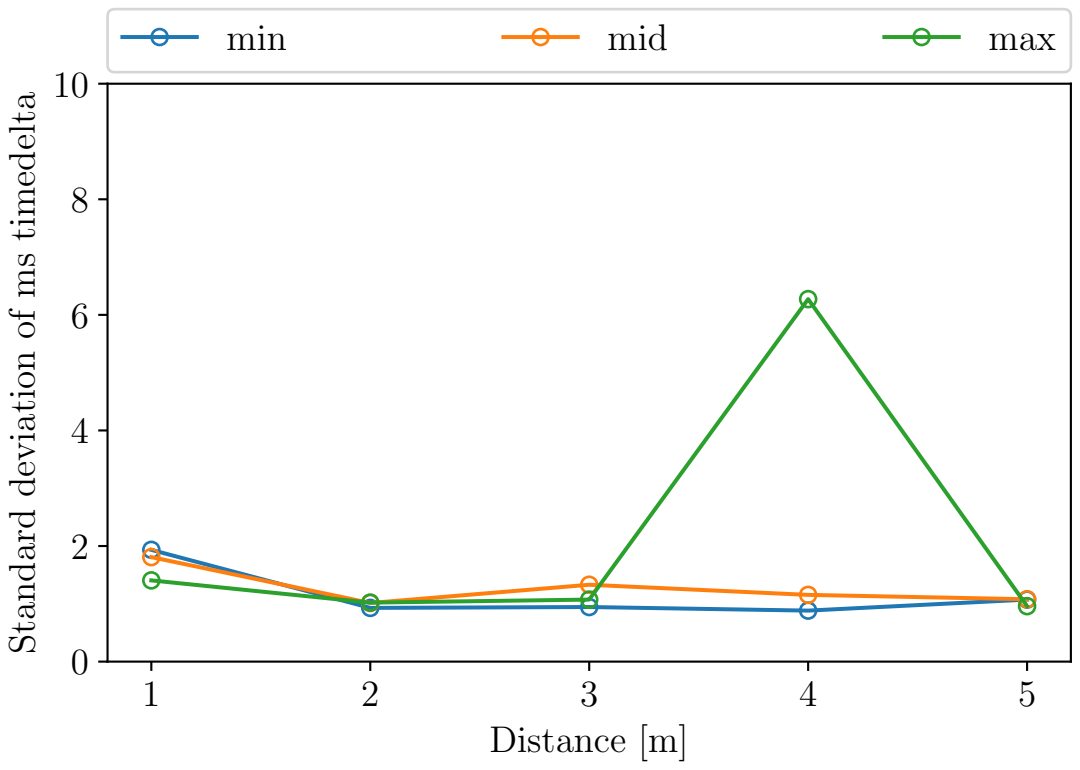
[picture p42: page 1]
Distance [m]; min; mid; max

Standard deviation of ms timedelta
