ledangaravi/sync-module/Testing/rx_test/rx_graphs/rx_indoors_std_180.pdf

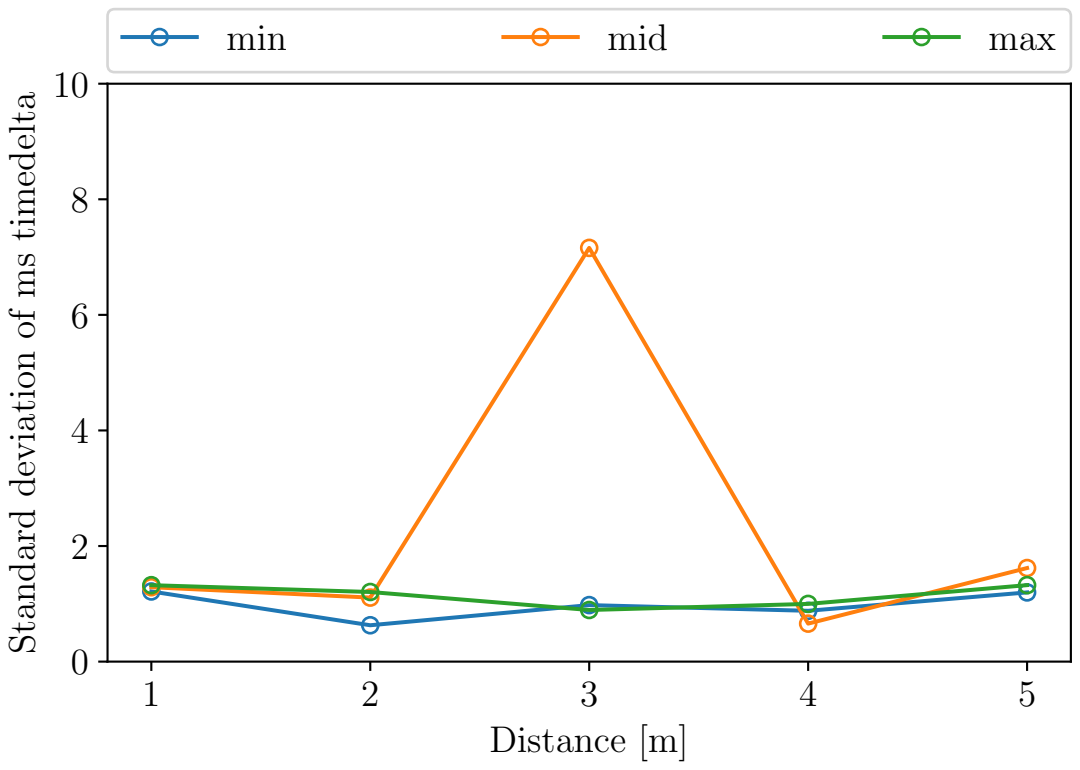
[picture p43: page 1]
Distance [m]; min; mid; max

Standard deviation of ms timedelta
