ledangaravi/sync-module/Testing/rx_test/rx_graphs/rx_indoors_std_90.pdf

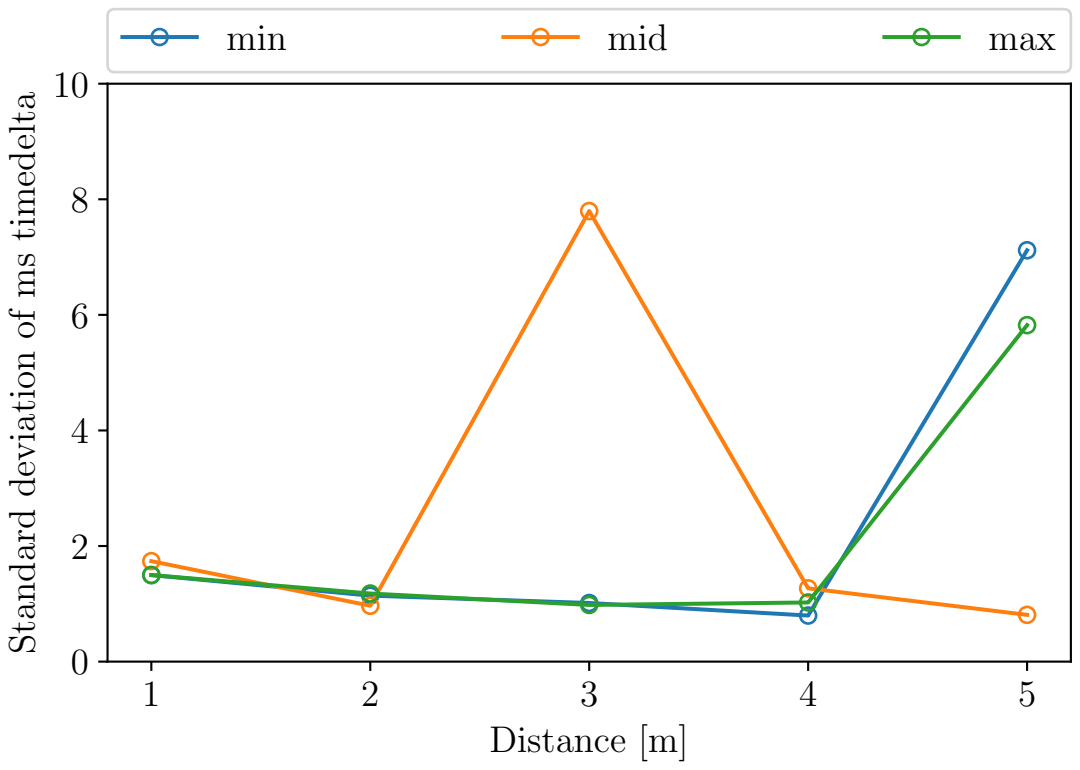
[picture p44: page 1]
Distance [m]; min; mid; max

Standard deviation of ms timedelta
