ledangaravi/sync-module/PCB/led_board/schematic/led_board.pdf

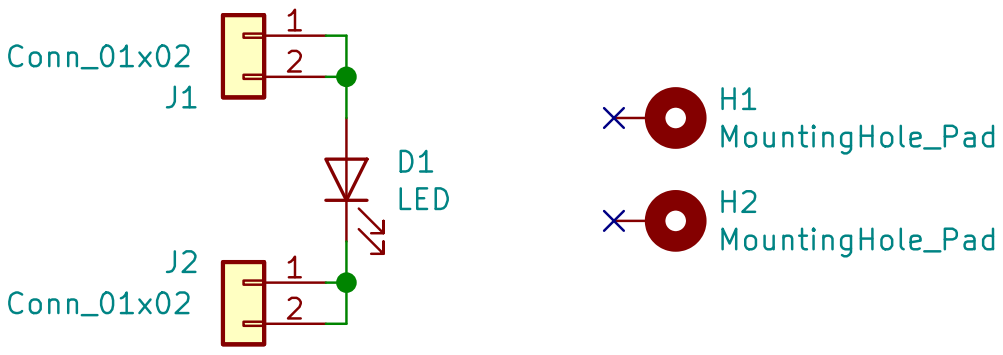
[picture p45: page 1]
