ledangaravi/sync-module/Testing/rx_test/rx_graphs/just_success_rate/rx_outdoors_night.pdf

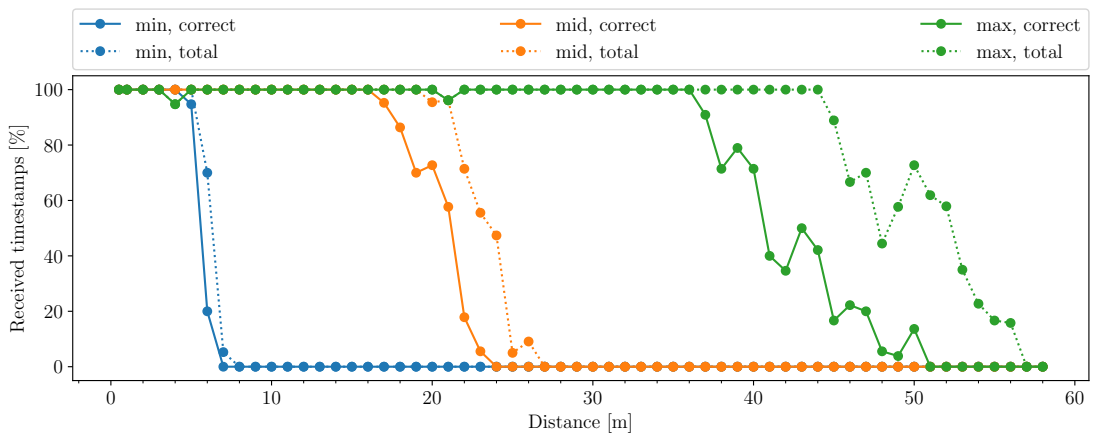
[picture p48: page 1]
Distance [m]; Received timestamps [%]; min, correct min, total; mid, correct mid, total; max, correct max, total
