ledangaravi/sync-module/PCB/led_board/led_board.kicad_pcb

## KiCad design PCB/led_board/led_board.kicad_pcb (2020-06-19)

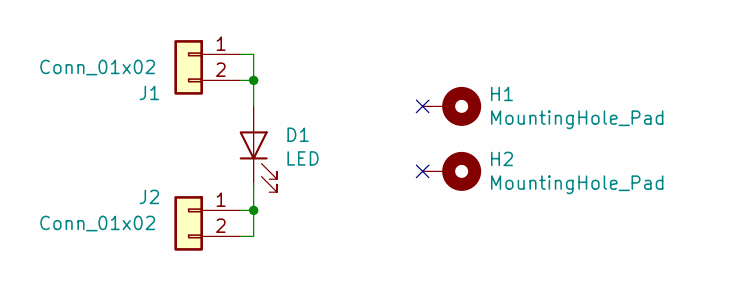
[picture p52: schematic led_board.sch]

Parts:
D1: LED; SFH4726AS
H1, H2: MountingHole_Pad; MountingHole_2.7mm_M2.5_Pad
J1, J2: Conn_01x02; SolderWirePad_1x02_P3.81mm_Drill1.2mm

Connections:
unnamed: D1.1 (K), J2.1, J2.2
unnamed: D1.2 (A), J1.1, J1.2

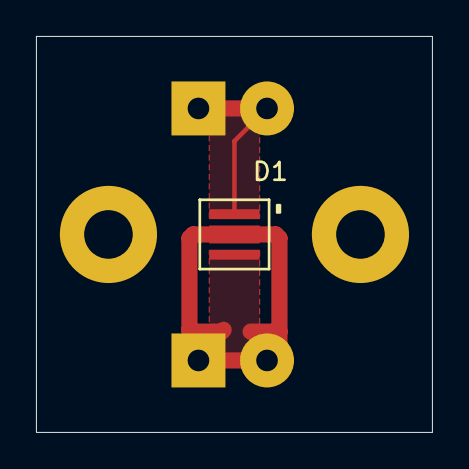
[picture p53: board led_board.kicad_pcb from above]

Board: 2 copper layers, 22.0 x 22.0 mm, 5 parts (0 on the bottom side), 2 nets.
