ledangaravi/sync-module/PCB/sync_module/sync_module.kicad_pcb

## KiCad design PCB/sync_module/sync_module.kicad_pcb (2020-06-19)

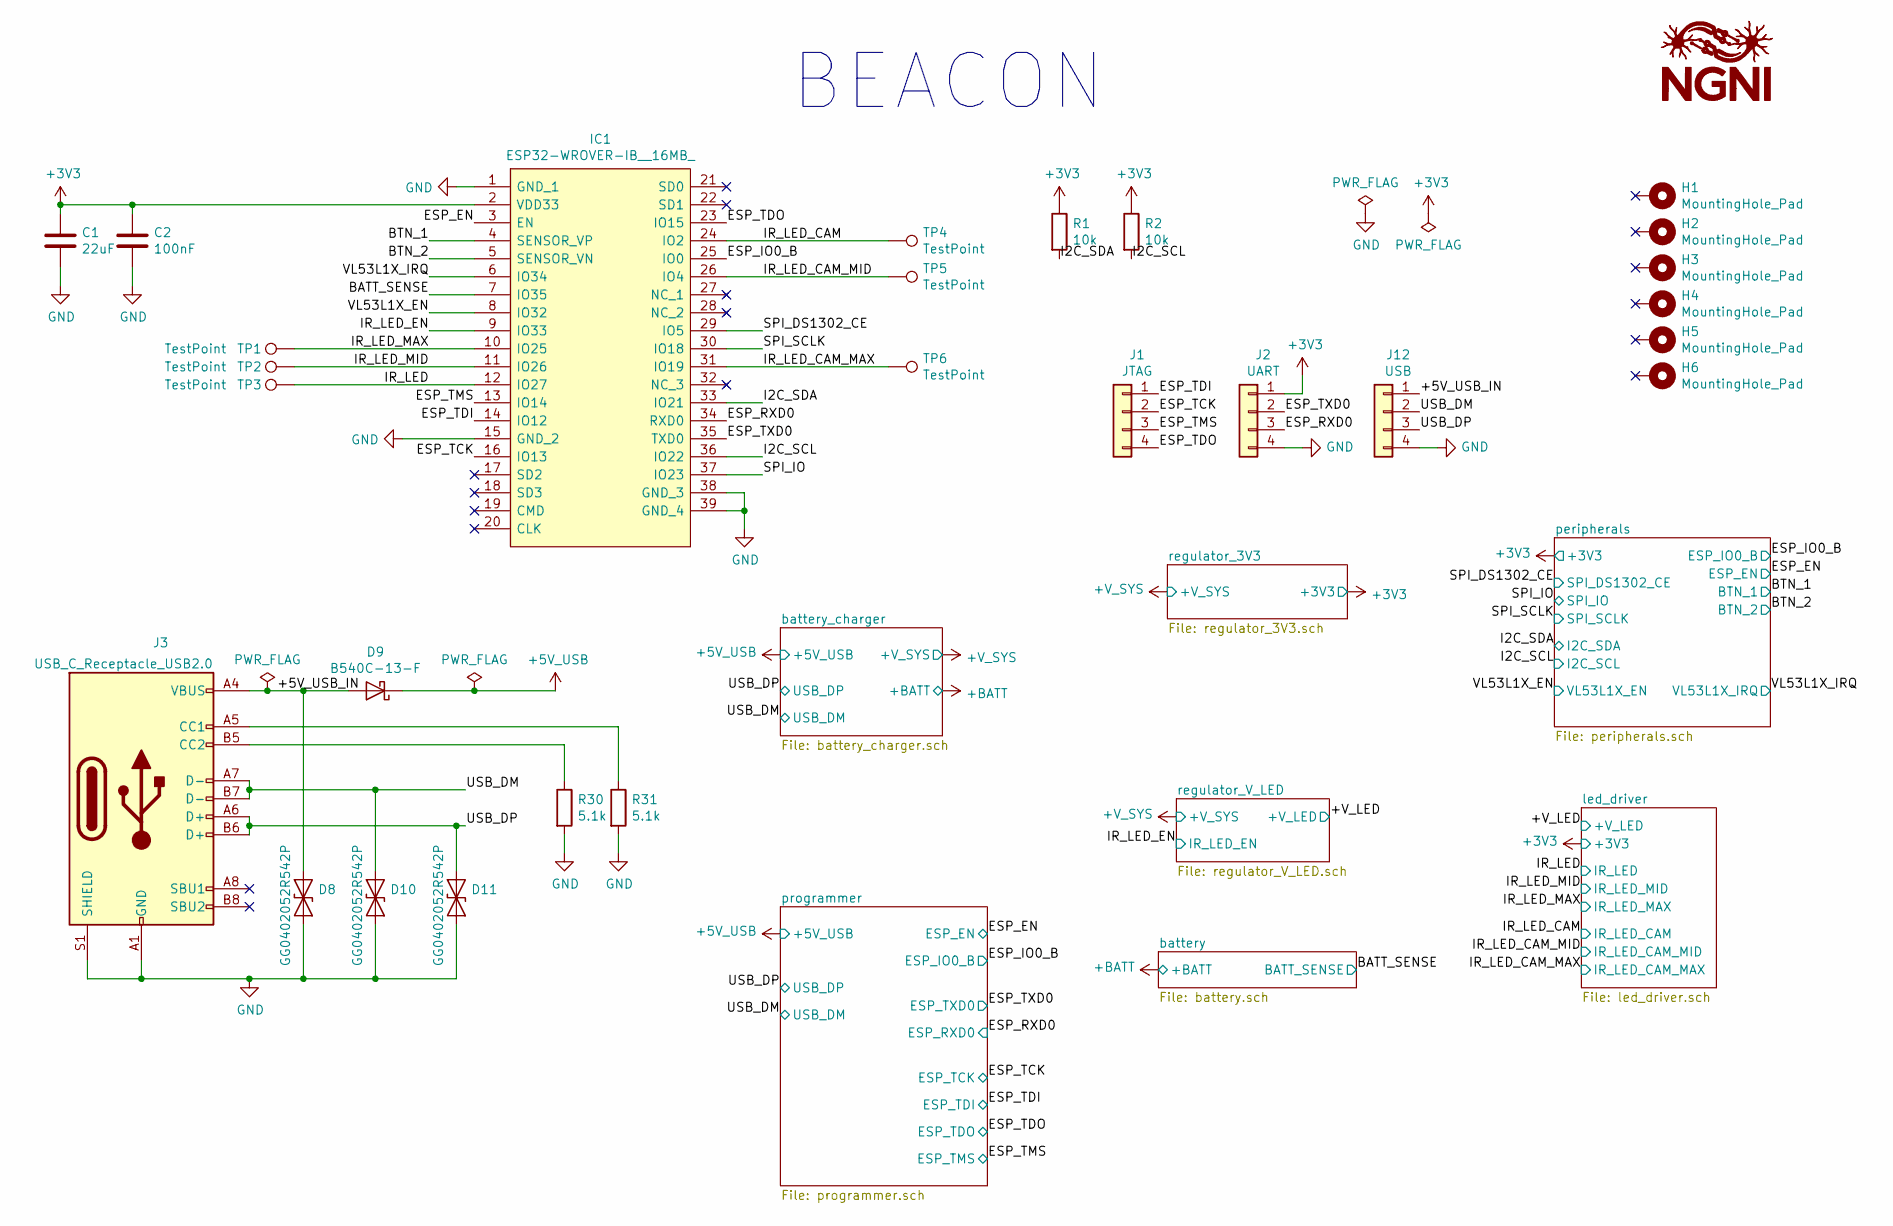
[picture p54: schematic sync_module.sch]

Parts:
C1: 22uF; C_0805_2012Metric_Pad1.15x1.40mm_HandSolder
C2: 100nF; C_0603_1608Metric_Pad1.05x0.95mm_HandSolder
D8, D10, D11: GG0402052R542P; D_0402_1005Metric
D9: B540C-13-F; D_SMC
G1: LOGO; ngni_logo
H1, H2, H3, H4, H5, H6: MountingHole_Pad; MountingHole_2.7mm_M2.5_Pad
IC1: ESP32-WROVER-IB__16MB_; ESP32WROVERIB16MB; Mouser Part Number 356-ESP32WROIB(16MB)
J1: JTAG; PinHeader_1x04_P2.54mm_Vertical
J2: UART; PinHeader_1x04_P2.54mm_Vertical
J3: USB_C_Receptacle_USB2.0; USB_C_Receptacle_HIROSE_CX90M-16P
J12: USB; PinHeader_1x04_P2.54mm_Vertical
R1, R2: 10k; R_0603_1608Metric_Pad1.05x0.95mm_HandSolder
R30, R31: 5.1k; R_0603_1608Metric_Pad1.05x0.95mm_HandSolder
TP1, TP2, TP3, TP4, TP5, TP6: TestPoint; TestPoint_Loop_D1.80mm_Drill1.0mm_Beaded

Connections:
+5V_USB: D9.1 (K); also elsewhere on the board
/+5V_USB_IN: D8.1 (A1), D9.2 (A), J3.A4 (VBUS), J3.A9 (VBUS), J3.B4 (VBUS), J3.B9 (VBUS), J12.1
/BATT_SENSE: IC1.7 (IO35); also elsewhere on the board
/BTN_1: IC1.4 (SENSOR_VP); also elsewhere on the board
/BTN_2: IC1.5 (SENSOR_VN); also elsewhere on the board
/ESP_EN: IC1.3 (EN); also elsewhere on the board
/ESP_IO0_B: IC1.25 (IO0); also elsewhere on the board
/ESP_RXD0: IC1.34 (RXD0), J2.3; also elsewhere on the board
/ESP_TCK: IC1.16 (IO13), J1.2; also elsewhere on the board
/ESP_TDI: IC1.14 (IO12), J1.1; also elsewhere on the board
/ESP_TDO: IC1.23 (IO15), J1.4; also elsewhere on the board
/ESP_TMS: IC1.13 (IO14), J1.3; also elsewhere on the board
/ESP_TXD0: IC1.35 (TXD0), J2.2; also elsewhere on the board
/I2C_SCL: IC1.36 (IO22), R2.2; also elsewhere on the board
/I2C_SDA: IC1.33 (IO21), R1.2; also elsewhere on the board
/IR_LED: IC1.12 (IO27), TP3.1; also elsewhere on the board
/IR_LED_CAM: IC1.24 (IO2), TP4.1; also elsewhere on the board
/IR_LED_CAM_MAX: IC1.31 (IO19), TP6.1; also elsewhere on the board
/IR_LED_CAM_MID: IC1.26 (IO4), TP5.1; also elsewhere on the board
/IR_LED_EN: IC1.9 (IO33); also elsewhere on the board
/IR_LED_MAX: IC1.10 (IO25), TP1.1; also elsewhere on the board
/IR_LED_MID: IC1.11 (IO26), TP2.1; also elsewhere on the board
/SPI_DS1302_CE: IC1.29 (IO5); also elsewhere on the board
/SPI_MOSI: IC1.37 (IO23); also elsewhere on the board
/SPI_SCLK: IC1.30 (IO18); also elsewhere on the board
/USB_DM: D10.1 (A1), J3.A7 (D-), J3.B7 (D-), J12.2; also elsewhere on the board
/USB_DP: D11.1 (A1), J3.A6 (D+), J3.B6 (D+), J12.3; also elsewhere on the board
/VL53L1X_EN: IC1.8 (IO32); also elsewhere on the board
/VL53L1X_IRQ: IC1.6 (IO34); also elsewhere on the board
GND: C1.2, C2.2, D8.2 (A2), D10.2 (A2), D11.2 (A2), IC1.1 (GND_1), IC1.15 (GND_2), IC1.38 (GND_3), IC1.39 (GND_4), J2.4, J3.A1 (GND), J3.A12 (GND), J3.B1 (GND), J3.B12 (GND), J3.S1 (SHIELD), J12.4, R30.2, R31.2; also elsewhere on the board
unnamed: J3.A5 (CC1), R31.1
unnamed: J3.B5 (CC2), R30.1

Notes on the sheet:
BEACON

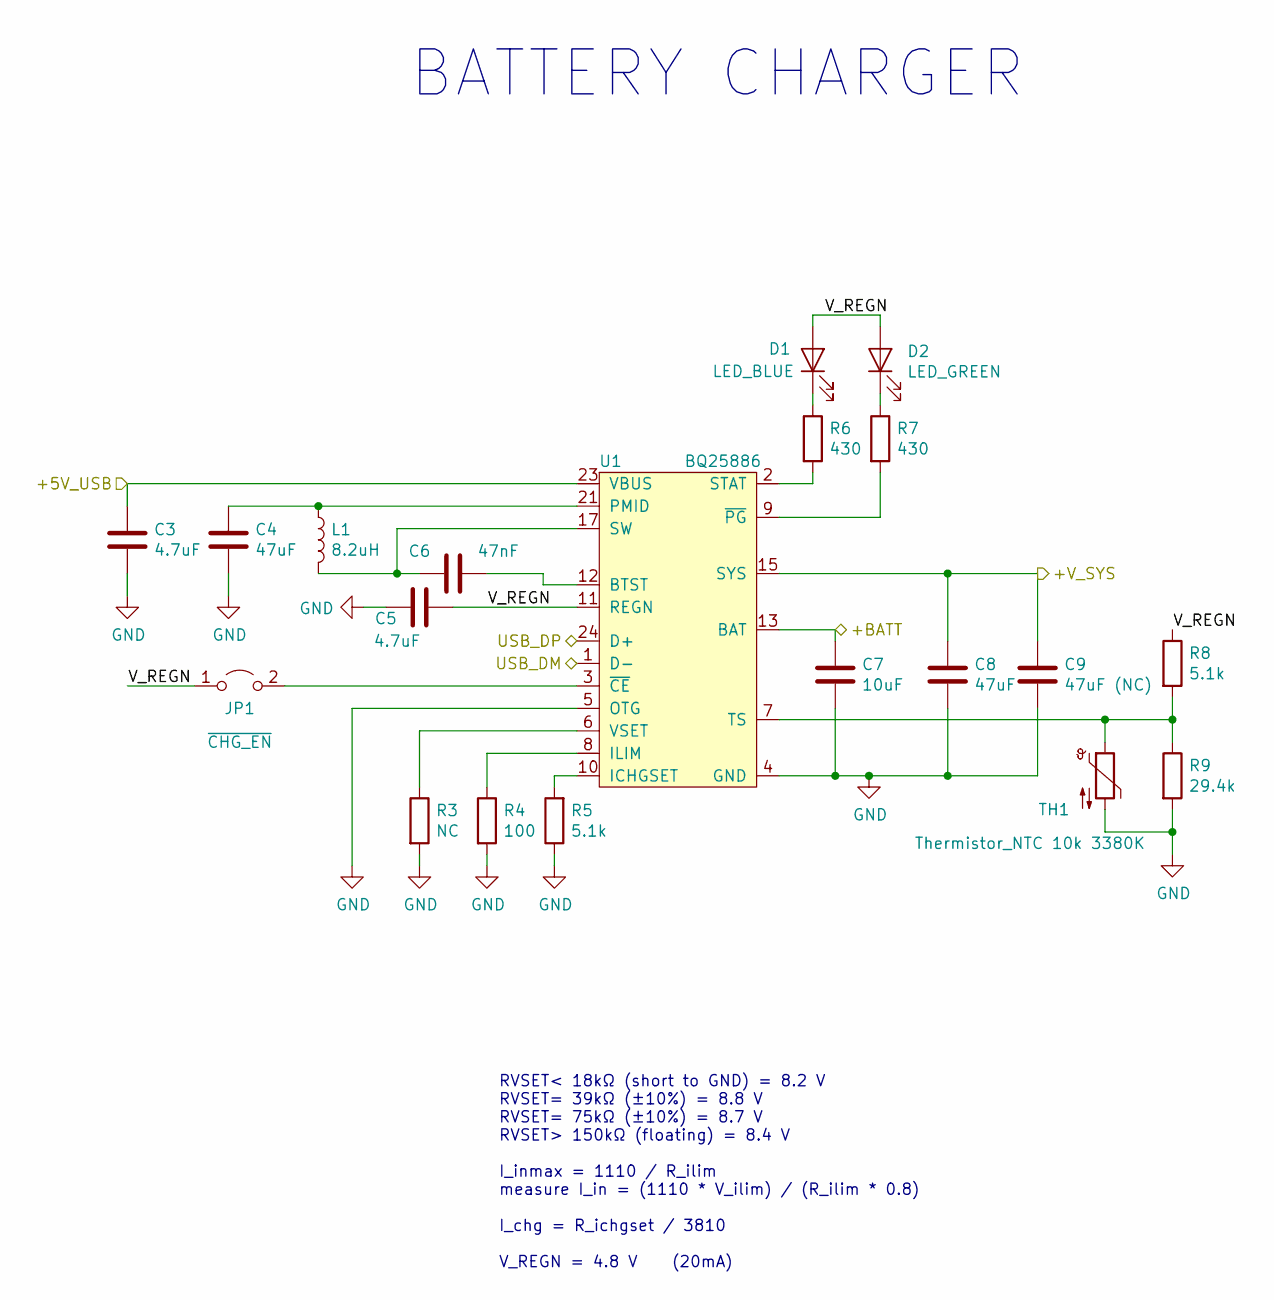
[picture p55: schematic battery_charger.sch]

Parts:
C3, C5: 4.7uF; C_0603_1608Metric_Pad1.05x0.95mm_HandSolder
C4, C8: 47uF; C_1210_3225Metric_Pad1.42x2.65mm_HandSolder
C6: 47nF; C_0603_1608Metric_Pad1.05x0.95mm_HandSolder
C7: 10uF; C_0805_2012Metric_Pad1.15x1.40mm_HandSolder
C9: 47uF (NC); C_1210_3225Metric_Pad1.42x2.65mm_HandSolder
D1: LED_BLUE; LED_0603_1608Metric_Pad1.05x0.95mm_HandSolder
D2: LED_GREEN; LED_0603_1608Metric_Pad1.05x0.95mm_HandSolder
JP1: ~CHG_EN; PinHeader_1x02_P2.54mm_Vertical
L1: 8.2uH; L_12.5x12.5mm_H6mm
R3: NC; R_0603_1608Metric_Pad1.05x0.95mm_HandSolder
R4: 100; R_0603_1608Metric_Pad1.05x0.95mm_HandSolder
R5, R8: 5.1k; R_0603_1608Metric_Pad1.05x0.95mm_HandSolder
R6, R7: 430; R_0603_1608Metric_Pad1.05x0.95mm_HandSolder
R9: 29.4k; R_0603_1608Metric_Pad1.05x0.95mm_HandSolder
TH1: Thermistor_NTC 10k 3380K; R_0603_1608Metric_Pad1.05x0.95mm_HandSolder
U1: BQ25886; VQFN-24-1EP_4x4mm_P0.5mm_EP2.45x2.45mm_ThermalVias

Connections:
+5V_USB: C3.1, U1.23 (VBUS); also elsewhere on the board
+BATT: C7.1, U1.13 (BAT), U1.14 (BAT); also elsewhere on the board
+V_SYS: C8.1, C9.1, U1.15 (SYS), U1.16 (SYS); also elsewhere on the board
/USB_DM: U1.1 (D-); also elsewhere on the board
/USB_DP: U1.24 (D+); also elsewhere on the board
/battery_charger/V_REGN: C5.1, D1.2 (A), D2.2 (A), JP1.1 (A), R8.1, U1.11 (REGN)
GND: C3.2, C4.2, C5.2, C7.2, C8.2, C9.2, R3.2, R4.2, R5.1, R9.2, TH1.2, U1.4 (GND), U1.5 (OTG), U1.19 (GND), U1.20 (GND), U1.25 (PAD); also elsewhere on the board
unnamed: C4.1, L1.1, U1.21 (PMID), U1.22 (PMID)
unnamed: C6.1, U1.12 (BTST)
unnamed: C6.2, L1.2, U1.17 (SW), U1.18 (SW)
unnamed: D1.1 (K), R6.1
unnamed: D2.1 (K), R7.1
unnamed: JP1.2 (B), U1.3 (~CE)
unnamed: R3.1, U1.6 (VSET)
unnamed: R4.1, U1.8 (ILIM)
unnamed: R5.2, U1.10 (ICHGSET)
unnamed: R6.2, U1.2 (STAT)
unnamed: R7.2, U1.9 (~PG)
unnamed: R8.2, R9.1, TH1.1, U1.7 (TS)

Notes on the sheet:
RVSET< 18kΩ (short to GND) = 8.2 V RVSET= 39kΩ (±10%) = 8.8 V RVSET= 75kΩ (±10%) = 8.7 V RVSET> 150kΩ (floating) = 8.4 V I_inmax = 1110 / R_ilim measure I_in = (1110 * V_ilim) / (R_ilim * 0.8) I_chg = R_ichgset / 3810 V_REGN = 4.8 V (20mA)
BATTERY CHARGER

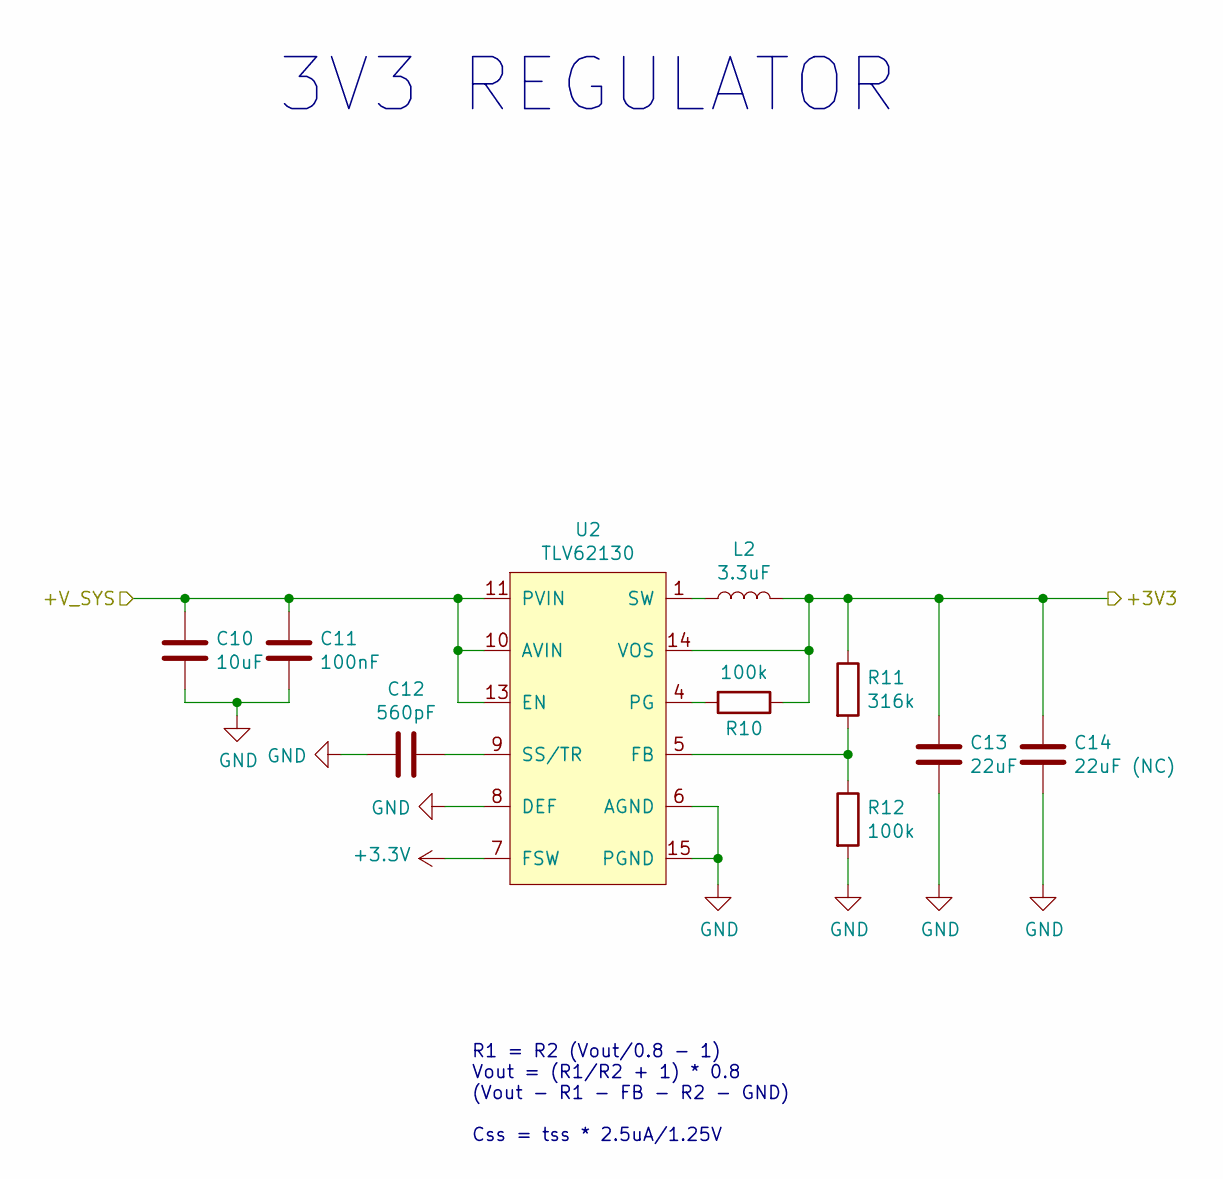
[picture p56: schematic regulator_3V3.sch]

Parts:
C10: 10uF; C_0805_2012Metric_Pad1.15x1.40mm_HandSolder
C11: 100nF; C_0603_1608Metric_Pad1.05x0.95mm_HandSolder
C12: 560pF; C_0603_1608Metric_Pad1.05x0.95mm_HandSolder
C13: 22uF; C_0805_2012Metric_Pad1.15x1.40mm_HandSolder
C14: 22uF (NC); C_0805_2012Metric_Pad1.15x1.40mm_HandSolder
L2: 3.3uF; L_7.8x6.7_H4
R10, R12: 100k; R_0603_1608Metric_Pad1.05x0.95mm_HandSolder
R11: 316k; R_0603_1608Metric_Pad1.05x0.95mm_HandSolder
U2: TLV62130; VQFN-16-1EP_3x3mm_P0.5mm_EP1.68x1.68mm_ThermalVias

Connections:
+V_SYS: C10.1, C11.1, U2.10 (AVIN), U2.11 (PVIN), U2.12 (PVIN), U2.13 (EN); also elsewhere on the board
GND: C10.2, C11.2, C12.2, C13.2, C14.2, R12.2, U2.6 (AGND), U2.8 (DEF), U2.15 (PGND), U2.16 (PGND), U2.17 (PAD); also elsewhere on the board
unnamed: C12.1, U2.9 (SS/TR)
unnamed: L2.1, U2.1 (SW), U2.2 (SW), U2.3 (SW)
unnamed: R10.2, U2.4 (PG)
unnamed: R11.2, R12.1, U2.5 (FB)

Notes on the sheet:
R1 = R2 (Vout/0.8 - 1) Vout = (R1/R2 + 1) * 0.8 (Vout - R1 - FB - R2 - GND) Css = tss * 2.5uA/1.25V
3V3 REGULATOR

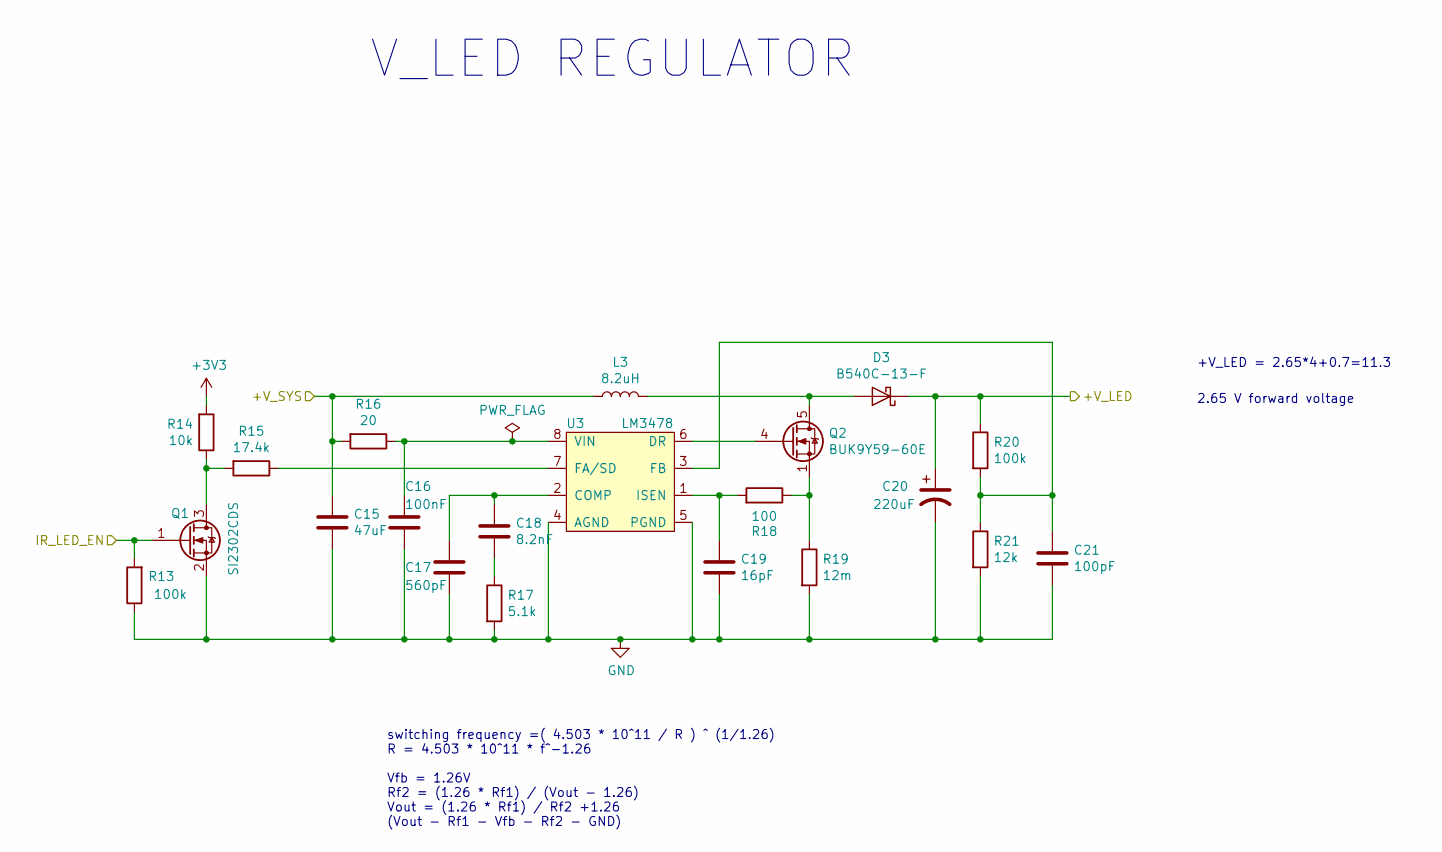
[picture p57: schematic regulator_V_LED.sch]

Parts:
C15: 47uF; C_1210_3225Metric_Pad1.42x2.65mm_HandSolder
C16: 100nF; C_0603_1608Metric_Pad1.05x0.95mm_HandSolder
C17: 560pF; C_0603_1608Metric_Pad1.05x0.95mm_HandSolder
C18: 8.2nF; C_0603_1608Metric_Pad1.05x0.95mm_HandSolder
C19: 16pF; C_0603_1608Metric_Pad1.05x0.95mm_HandSolder
C20: 220uF; CP_Radial_D8.0mm_P3.50mm
C21: 100pF; C_0603_1608Metric_Pad1.05x0.95mm_HandSolder
D3: B540C-13-F; D_SMC
L3: 8.2uH; L_12.5x12.5mm_H6mm
Q1: SI2302CDS; SOT-23
Q2: BUK9Y59-60E; LFPAK56
R13, R20: 100k; R_0603_1608Metric_Pad1.05x0.95mm_HandSolder
R14: 10k; R_0603_1608Metric_Pad1.05x0.95mm_HandSolder
R15: 17.4k; R_0603_1608Metric_Pad1.05x0.95mm_HandSolder
R16: 20; R_0603_1608Metric_Pad1.05x0.95mm_HandSolder
R17: 5.1k; R_0603_1608Metric_Pad1.05x0.95mm_HandSolder
R18: 100; R_0603_1608Metric_Pad1.05x0.95mm_HandSolder
R19: 12m; R_2512_6332Metric_Pad1.52x3.35mm_HandSolder
R21: 12k; R_0603_1608Metric_Pad1.05x0.95mm_HandSolder
U3: LM3478; SOIC-8_3.9x4.9mm_P1.27mm

Connections:
+V_SYS: C15.2, L3.1, R16.2; also elsewhere on the board
/+V_LED: C20.1, D3.1 (K), R20.1; also elsewhere on the board
/IR_LED_EN: Q1.1 (G), R13.2; also elsewhere on the board
GND: C15.1, C16.1, C17.2, C19.2, C20.2, C21.2, Q1.2 (S), R13.1, R17.2, R19.2, R21.2, U3.4 (AGND), U3.5 (PGND); also elsewhere on the board
unnamed: C16.2, R16.1, U3.8 (VIN)
unnamed: C17.1, C18.1, U3.2 (COMP)
unnamed: C18.2, R17.1
unnamed: C19.1, R18.2, U3.1 (ISEN)
unnamed: C21.1, R20.2, R21.1, U3.3 (FB)
unnamed: D3.2 (A), L3.2, Q2.5 (D)
unnamed: Q1.3 (D), R14.1, R15.2
unnamed: Q2.1 (S), Q2.2 (S), Q2.3 (S), R18.1, R19.1
unnamed: Q2.4 (G), U3.6 (DR)
unnamed: R15.1, U3.7 (FA/SD)

Notes on the sheet:
switching frequency =( 4.503 * 10^11 / R ) ^ (1/1.26) R = 4.503 * 10^11 * f^-1.26 Vfb = 1.26V Rf2 = (1.26 * Rf1) / (Vout - 1.26) Vout = (1.26 * Rf1) / Rf2 +1.26 (Vout - Rf1 - Vfb - Rf2 - GND)
+V_LED = 2.65*4+0.7=11.3
2.65 V forward voltage
V_LED REGULATOR

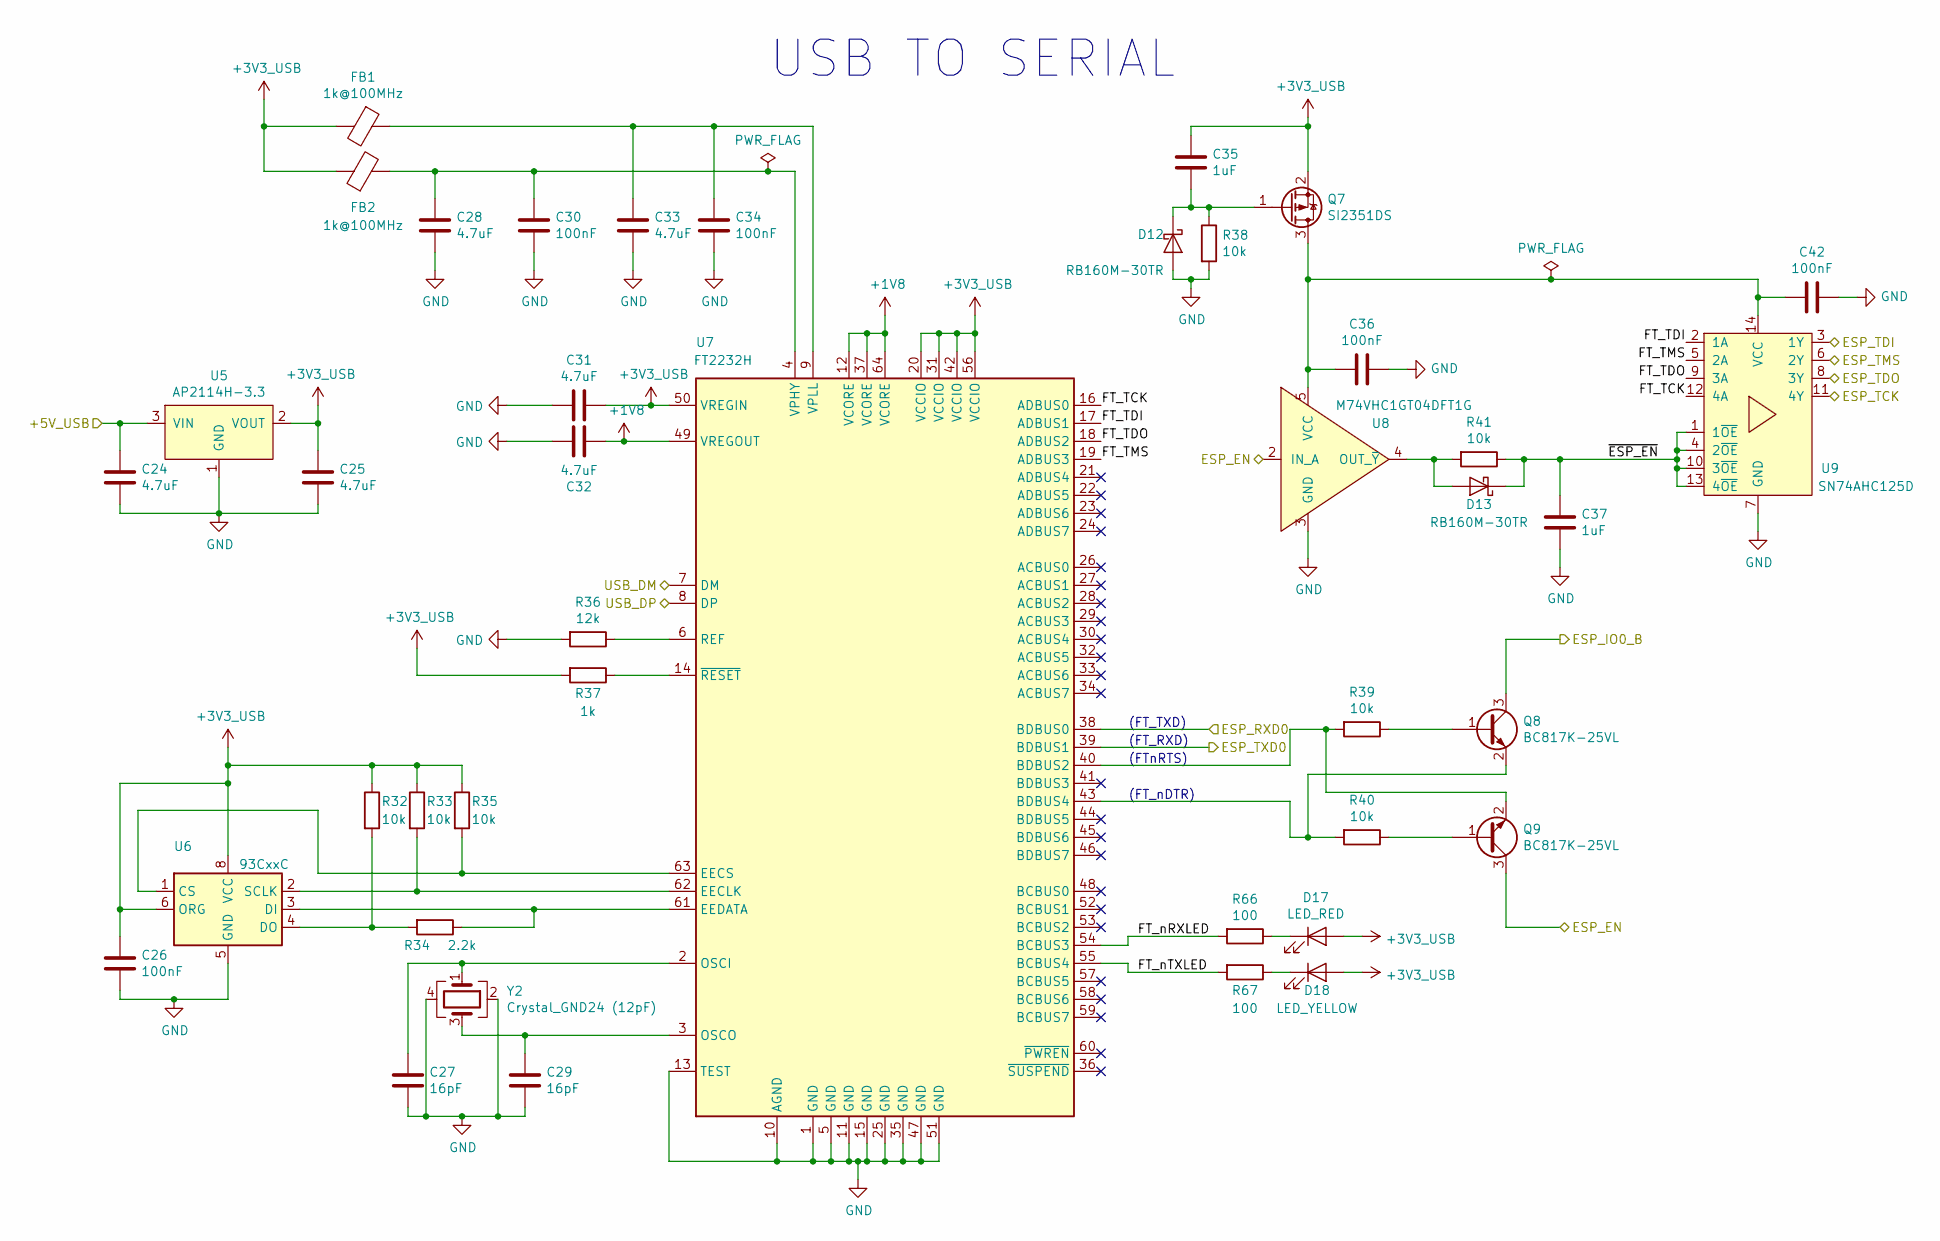
[picture p58: schematic programmer.sch]

Parts:
C24, C25, C28, C31, C32, C33: 4.7uF; C_0603_1608Metric_Pad1.05x0.95mm_HandSolder
C26, C30, C34, C36, C42: 100nF; C_0603_1608Metric_Pad1.05x0.95mm_HandSolder
C27, C29: 16pF; C_0603_1608Metric_Pad1.05x0.95mm_HandSolder
C35, C37: 1uF; C_0603_1608Metric_Pad1.05x0.95mm_HandSolder
D12, D13: RB160M-30TR; D_SOD-123
D17: LED_RED; LED_0603_1608Metric_Pad1.05x0.95mm_HandSolder
D18: LED_YELLOW; LED_0603_1608Metric_Pad1.05x0.95mm_HandSolder
FB1, FB2: 1k@100MHz; R_0603_1608Metric_Pad1.05x0.95mm_HandSolder
Q7: SI2351DS; SOT-23
Q8, Q9: BC817K-25VL; SOT-23
R32, R33, R35, R38, R39, R40, R41: 10k; R_0603_1608Metric_Pad1.05x0.95mm_HandSolder
R34: 2.2k; R_0603_1608Metric_Pad1.05x0.95mm_HandSolder
R36: 12k; R_0603_1608Metric_Pad1.05x0.95mm_HandSolder
R37: 1k; R_0603_1608Metric_Pad1.05x0.95mm_HandSolder
R66, R67: 100; R_0603_1608Metric_Pad1.05x0.95mm_HandSolder
U5: AP2114H-3.3; SOT-223-3_TabPin2
U6: 93CxxC; SOIC-8_3.9x4.9mm_P1.27mm
U7: FT2232H; LQFP-64_10x10mm_P0.5mm
U8: M74VHC1GT04DFT1G; SOT-353_SC-70-5
U9: SN74AHC125D; SOIC-14_3.9x8.7mm_P1.27mm
Y2: Crystal_GND24 (12pF); Crystal_SMD_3225-4Pin_3.2x2.5mm

Connections:
+1V8: C32.2, U7.12 (VCORE), U7.37 (VCORE), U7.49 (VREGOUT), U7.64 (VCORE)
+3V3_USB: C25.1, C26.1, C31.1, C35.1, D17.2 (A), D18.2 (A), FB1.2, FB2.1, Q7.2 (S), R32.1, R33.1, R35.1, R37.2, U5.2 (VOUT), U6.6 (ORG), U6.8 (VCC), U7.20 (VCCIO), U7.31 (VCCIO), U7.42 (VCCIO), U7.50 (VREGIN), U7.56 (VCCIO)
+5V_USB: C24.1, U5.3 (VIN); also elsewhere on the board
/ESP_EN: Q9.3 (C), U8.2 (IN_A); also elsewhere on the board
/ESP_IO0_B: Q8.3 (C); also elsewhere on the board
/ESP_RXD0: U7.38 (BDBUS0); also elsewhere on the board
/ESP_TCK: U9.11 (4Y); also elsewhere on the board
/ESP_TDI: U9.3 (1Y); also elsewhere on the board
/ESP_TDO: U9.8 (3Y); also elsewhere on the board
/ESP_TMS: U9.6 (2Y); also elsewhere on the board
/ESP_TXD0: U7.39 (BDBUS1); also elsewhere on the board
/USB_DM: U7.7 (DM); also elsewhere on the board
/USB_DP: U7.8 (DP); also elsewhere on the board
/programmer/FT_TCK: U7.16 (ADBUS0), U9.12 (4A)
/programmer/FT_TDI: U7.17 (ADBUS1), U9.2 (1A)
/programmer/FT_TDO: U7.18 (ADBUS2), U9.9 (3A)
/programmer/FT_TMS: U7.19 (ADBUS3), U9.5 (2A)
/programmer/FT_nRXLED: R66.2, U7.54 (BCBUS3)
/programmer/FT_nTXLED: R67.2, U7.55 (BCBUS4)
/programmer/~ESP_EN: C37.1, D13.1 (K), R41.1, U9.1 (1~OE), U9.4 (2~OE), U9.10 (3~OE), U9.13 (4~OE)
GND: C24.2, C25.2, C26.2, C27.2, C28.2, C29.2, C30.2, C31.2, C32.1, C33.2, C34.2, C36.1, C37.2, C42.2, D12.2 (A), R36.2, R38.2, U5.1 (GND), U6.5 (GND), U7.1 (GND), U7.5 (GND), U7.10 (AGND), U7.11 (GND), U7.13 (TEST), U7.15 (GND), U7.25 (GND), U7.35 (GND), U7.47 (GND), U7.51 (GND), U8.3 (GND), U9.7 (GND), Y2.2, Y2.4; also elsewhere on the board
unnamed: C27.1, U7.2 (OSCI), Y2.1
unnamed: C28.1, C30.1, FB2.2, U7.4 (VPHY)
unnamed: C29.1, U7.3 (OSCO), Y2.3
unnamed: C33.1, C34.1, FB1.1, U7.9 (VPLL)
unnamed: C35.2, D12.1 (K), Q7.1 (G), R38.1
unnamed: C36.2, C42.1, Q7.3 (D), U8.5 (VCC), U9.14 (VCC)
unnamed: D13.2 (A), R41.2, U8.4 (OUT_~Y)
unnamed: D17.1 (K), R66.1
unnamed: D18.1 (K), R67.1
unnamed: Q8.1 (B), R39.1
unnamed: Q8.2 (E), R40.2, U7.43 (BDBUS4)
unnamed: Q9.1 (B), R40.1
unnamed: Q9.2 (E), R39.2, U7.40 (BDBUS2)
unnamed: R32.2, R34.2, U6.4 (DO)
unnamed: R33.2, U6.2 (SCLK), U7.62 (EECLK)
unnamed: R34.1, U6.3 (DI), U7.61 (EEDATA)
unnamed: R35.2, U6.1 (CS), U7.63 (EECS)
unnamed: R36.1, U7.6 (REF)
unnamed: R37.1, U7.14 (~RESET)

Notes on the sheet:
(FT_TXD)
(FT_RXD)
(FTnRTS)
(FT_nDTR)
USB TO SERIAL

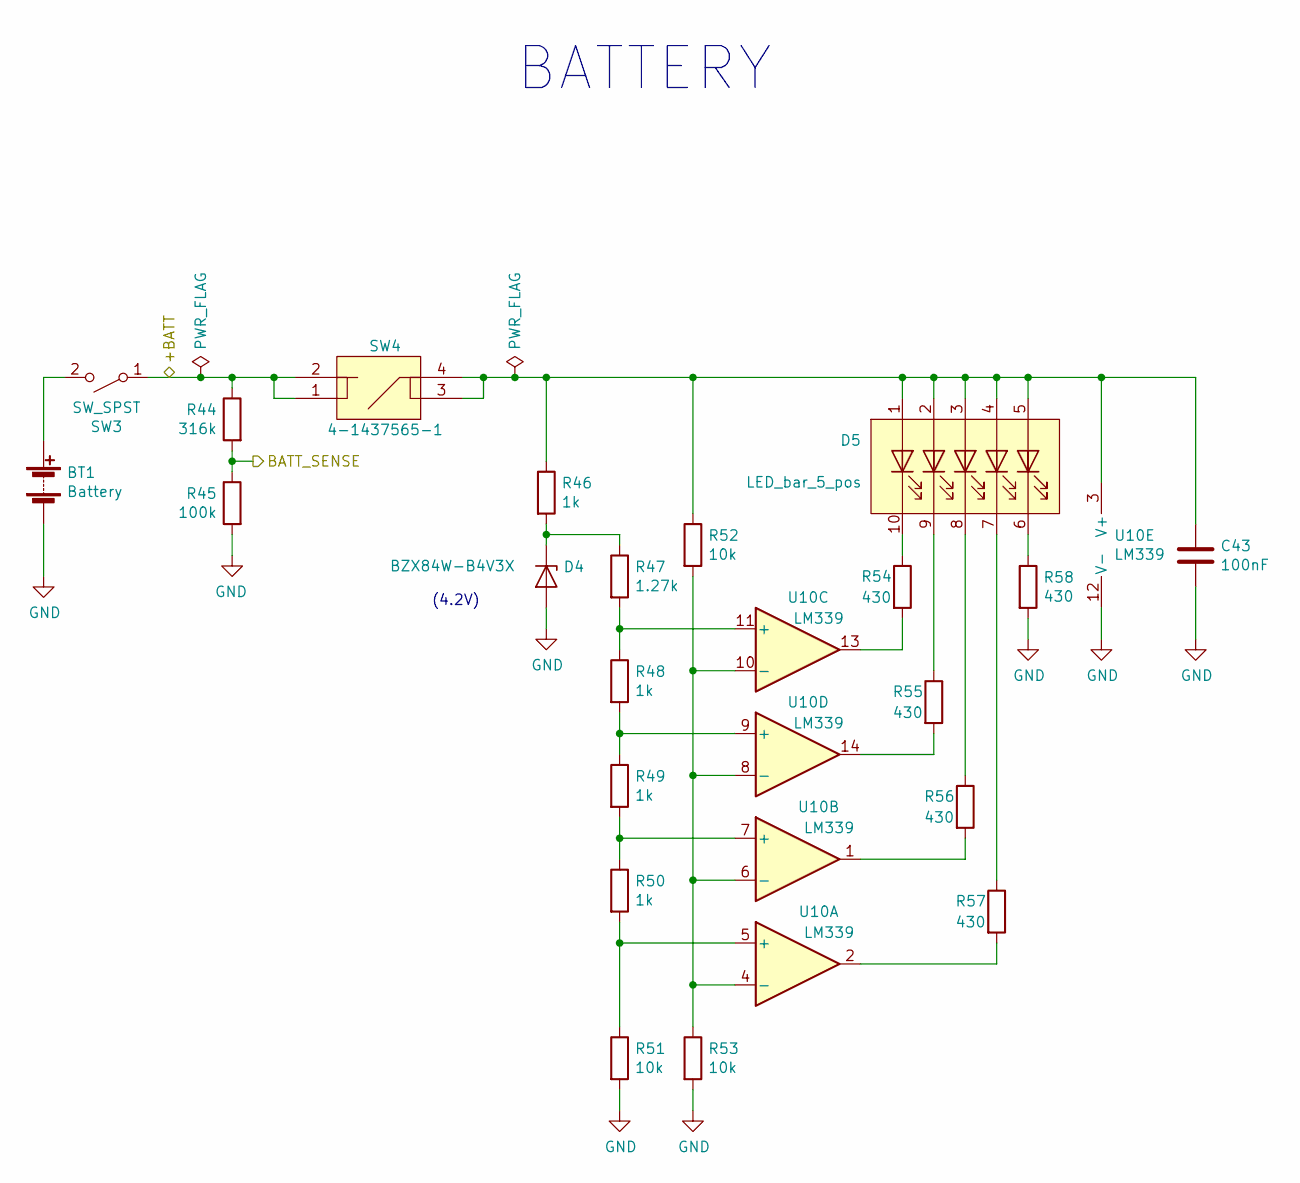
[picture p59: schematic battery.sch]

Parts:
BT1: Battery; Molex_KK-254_AE-6410-02A_1x02_P2.54mm_Vertical
C43: 100nF; C_0603_1608Metric_Pad1.05x0.95mm_HandSolder
D4: BZX84W-B4V3X; D_SOT-323_SC-70_ANK_Handsoldering
D5: LED_bar_5_pos; DC-05GWA_Kingbright_bar_graph_5_segment
R44: 316k; R_0603_1608Metric_Pad1.05x0.95mm_HandSolder
R45: 100k; R_0603_1608Metric_Pad1.05x0.95mm_HandSolder
R46, R48, R49, R50: 1k; R_0603_1608Metric_Pad1.05x0.95mm_HandSolder
R47: 1.27k; R_0603_1608Metric_Pad1.05x0.95mm_HandSolder
R51, R52, R53: 10k; R_0603_1608Metric_Pad1.05x0.95mm_HandSolder
R54, R55, R56, R57, R58: 430; R_0603_1608Metric_Pad1.05x0.95mm_HandSolder
SW3: SW_SPST; Molex_KK-254_AE-6410-02A_1x02_P2.54mm_Vertical
SW4: 4-1437565-1; FSM-SWITCH; Manufacturer_Part_Number 4-1437565-1
U10: LM339; SOIC-14_3.9x8.7mm_P1.27mm

Connections:
+BATT: R44.1, SW3.1 (A), SW4.1, SW4.2; also elsewhere on the board
/BATT_SENSE: R44.2, R45.1; also elsewhere on the board
GND: BT1.2 (-), C43.2, D4.2 (A), R45.2, R51.2, R53.2, R58.2, U10.12 (V-); also elsewhere on the board
unnamed: BT1.1 (+), SW3.2 (B)
unnamed 60: C43.1, D5.1, D5.2, D5.3, D5.4, D5.5, R46.1, R52.1, SW4.3, SW4.4, U10.3 (V+); also elsewhere on the board
unnamed 65: D4.1 (K), R46.2, R47.1; also elsewhere on the board
unnamed 66: D5.6, R58.1; also elsewhere on the board
unnamed 67: D5.7, R57.1; also elsewhere on the board
unnamed 68: D5.8, R56.1; also elsewhere on the board
unnamed 69: D5.9, R55.1; also elsewhere on the board
unnamed 70: D5.10, R54.1; also elsewhere on the board
unnamed: R47.2, R48.1, U10.11 (+)
unnamed: R48.2, R49.1, U10.9 (+)
unnamed: R49.2, R50.1, U10.7 (+)
unnamed: R50.2, R51.1, U10.5 (+)
unnamed: R52.2, R53.1, U10.4 (-), U10.6 (-), U10.8 (-), U10.10 (-)
unnamed: R54.2, U10.13
unnamed: R55.2, U10.14
unnamed: R56.2, U10.1
unnamed: R57.2, U10.2

Notes on the sheet:
BATTERY
(4.2V)

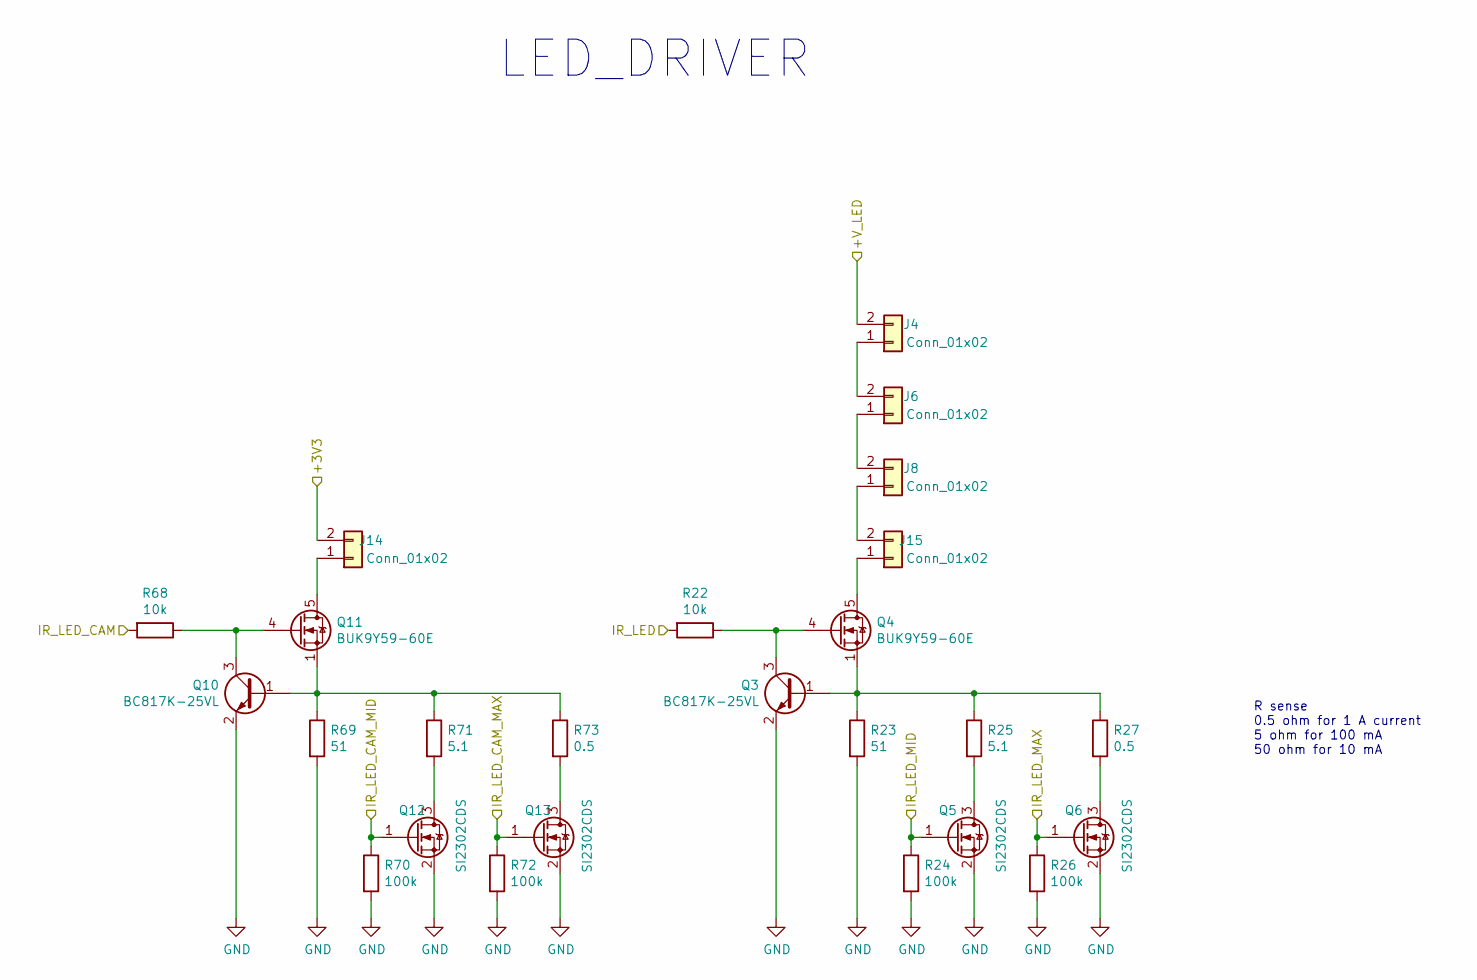
[picture p60: schematic led_driver.sch]

Parts:
J4, J6, J8, J14, J15: Conn_01x02; Molex_KK-254_AE-6410-02A_1x02_P2.54mm_Vertical
Q3, Q10: BC817K-25VL; SOT-23
Q4, Q11: BUK9Y59-60E; LFPAK56
Q5, Q6, Q12, Q13: SI2302CDS; SOT-23
R22, R68: 10k; R_0603_1608Metric_Pad1.05x0.95mm_HandSolder
R23, R69: 51; R_2512_6332Metric_Pad1.52x3.35mm_HandSolder
R24, R26, R70, R72: 100k; R_0603_1608Metric_Pad1.05x0.95mm_HandSolder
R25, R71: 5.1; R_2512_6332Metric_Pad1.52x3.35mm_HandSolder
R27, R73: 0.5; R_2512_6332Metric_Pad1.52x3.35mm_HandSolder

Connections:
/+V_LED: J4.2; also elsewhere on the board
/IR_LED: R22.2; also elsewhere on the board
/IR_LED_CAM: R68.2; also elsewhere on the board
/IR_LED_CAM_MAX: Q13.1 (G), R72.1; also elsewhere on the board
/IR_LED_CAM_MID: Q12.1 (G), R70.1; also elsewhere on the board
/IR_LED_MAX: Q6.1 (G), R26.1; also elsewhere on the board
/IR_LED_MID: Q5.1 (G), R24.1; also elsewhere on the board
GND: Q3.2 (E), Q5.2 (S), Q6.2 (S), Q10.2 (E), Q12.2 (S), Q13.2 (S), R23.2, R24.2, R26.2, R69.2, R70.2, R72.2; also elsewhere on the board
unnamed: J4.1, J6.2
unnamed: J6.1, J8.2
unnamed: J14.1, Q11.5 (D)
unnamed: J15.1, Q4.5 (D)
unnamed: J8.1, J15.2
unnamed: Q3.1 (B), Q4.1 (S), Q4.2 (S), Q4.3 (S), R23.1, R25.1, R27.1
unnamed: Q3.3 (C), Q4.4 (G), R22.1
unnamed: Q5.3 (D), R25.2
unnamed: Q6.3 (D), R27.2
unnamed: Q10.1 (B), Q11.1 (S), Q11.2 (S), Q11.3 (S), R69.1, R71.1, R73.1
unnamed: Q10.3 (C), Q11.4 (G), R68.1
unnamed: Q12.3 (D), R71.2
unnamed: Q13.3 (D), R73.2

Notes on the sheet:
R sense 0.5 ohm for 1 A current 5 ohm for 100 mA 50 ohm for 10 mA
LED_DRIVER
