ledangaravi/sync-module/PCB/sync_module/sync_module.kicad_pcb

## KiCad design PCB/sync_module/sync_module.kicad_pcb (continued)

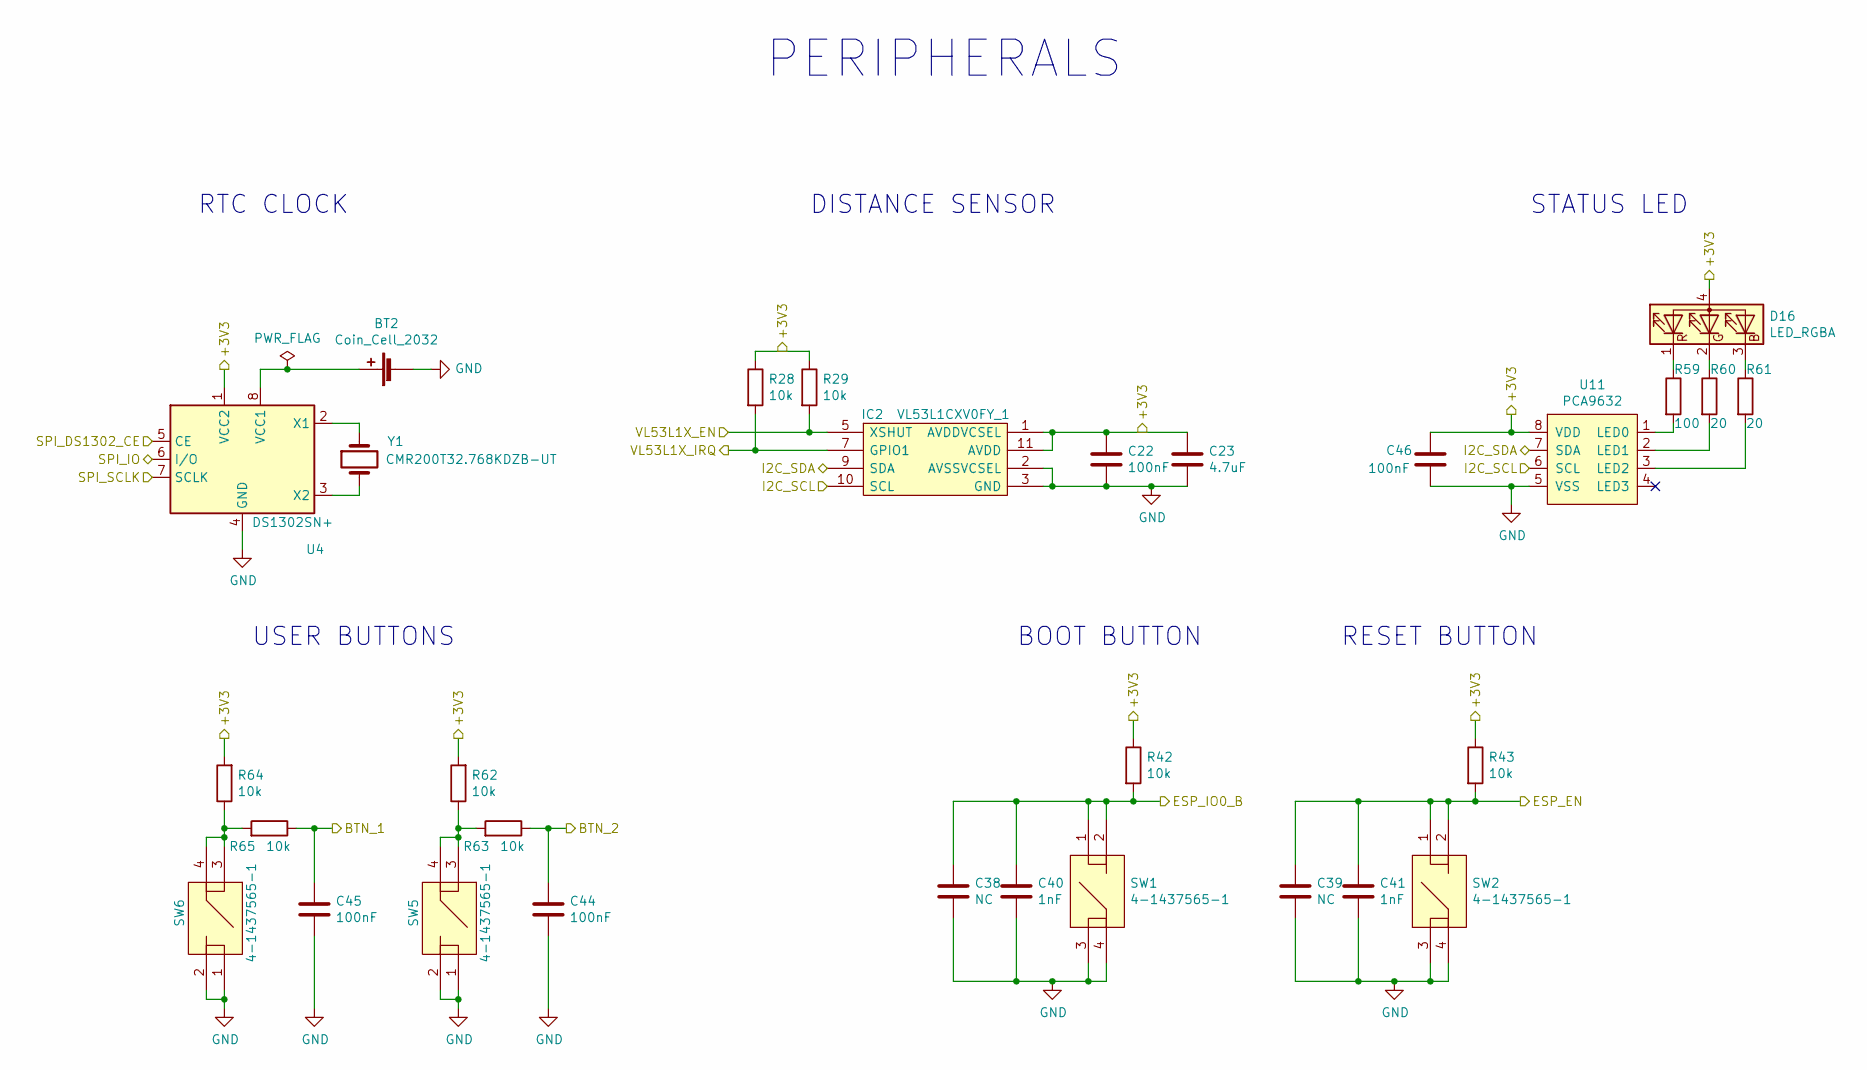
[picture p61: schematic peripherals.sch]

Parts:
BT2: Coin_Cell_2032; BC2001
C22, C44, C45, C46: 100nF; C_0603_1608Metric_Pad1.05x0.95mm_HandSolder
C23: 4.7uF; C_0603_1608Metric_Pad1.05x0.95mm_HandSolder
C38, C39: NC; C_0603_1608Metric_Pad1.05x0.95mm_HandSolder
C40, C41: 1nF; C_0603_1608Metric_Pad1.05x0.95mm_HandSolder
D16: LED_RGBA; LED_Avago_PLCC4_3.2x2.8mm_CW
IC2: VL53L1CXV0FY_1; VL53L1CXV0FY1; Manufacturer_Part_Number VL53L1CXV0FY/1; Mouser Part Number 511-VL53L1CXV0FY/1
R28, R29, R42, R43, R62, R63, R64, R65: 10k; R_0603_1608Metric_Pad1.05x0.95mm_HandSolder
R59: 100; R_0603_1608Metric_Pad1.05x0.95mm_HandSolder
R60, R61: 20; R_0603_1608Metric_Pad1.05x0.95mm_HandSolder
SW1, SW2, SW5, SW6: 4-1437565-1; FSM-SWITCH; Manufacturer_Part_Number 4-1437565-1
U4: DS1302SN+; SO-8_5.3x6.2mm_P1.27mm
U11: PCA9632; TSSOP-8_3x3mm_P0.65mm
Y1: CMR200T32.768KDZB-UT; Crystal_SMD_Citizen_CMR200T_2.0x6.1mm

Connections:
/BTN_1: C45.1, R65.1; also elsewhere on the board
/BTN_2: C44.1, R63.1; also elsewhere on the board
/ESP_EN: C39.1, C41.1, R43.2, SW2.1, SW2.2; also elsewhere on the board
/ESP_IO0_B: C38.1, C40.1, R42.2, SW1.1, SW1.2; also elsewhere on the board
/I2C_SCL: IC2.10 (SCL), U11.6 (SCL); also elsewhere on the board
/I2C_SDA: IC2.9 (SDA), U11.7 (SDA); also elsewhere on the board
/SPI_DS1302_CE: U4.5 (CE); also elsewhere on the board
/SPI_MOSI: U4.6 (I/O); also elsewhere on the board
/SPI_SCLK: U4.7 (SCLK); also elsewhere on the board
/VL53L1X_EN: IC2.5 (XSHUT), R29.2; also elsewhere on the board
/VL53L1X_IRQ: IC2.7 (GPIO1), R28.2; also elsewhere on the board
GND: BT2.2 (-), C22.2, C23.2, C38.2, C39.2, C40.2, C41.2, C44.2, C45.2, C46.2, IC2.2 (AVSSVCSEL), IC2.3 (GND), IC2.4 (GND2), IC2.6 (GND3), IC2.12 (GND4), SW1.3, SW1.4, SW2.3, SW2.4, SW5.1, SW5.2, SW6.1, SW6.2, U4.4 (GND), U11.5 (VSS); also elsewhere on the board
unnamed: BT2.1 (+), U4.8 (VCC1)
unnamed: D16.1 (RK), R59.1
unnamed: D16.2 (GK), R60.1
unnamed: D16.3 (BK), R61.1
unnamed: R59.2, U11.1 (LED0)
unnamed: R60.2, U11.2 (LED1)
unnamed: R61.2, U11.3 (LED2)
unnamed: R62.1, R63.2, SW5.3, SW5.4
unnamed: R64.1, R65.2, SW6.3, SW6.4
unnamed: U4.2 (X1), Y1.1
unnamed: U4.3 (X2), Y1.2

Notes on the sheet:
PERIPHERALS
RTC CLOCK
DISTANCE SENSOR
STATUS LED
BOOT BUTTON
RESET BUTTON
USER BUTTONS

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
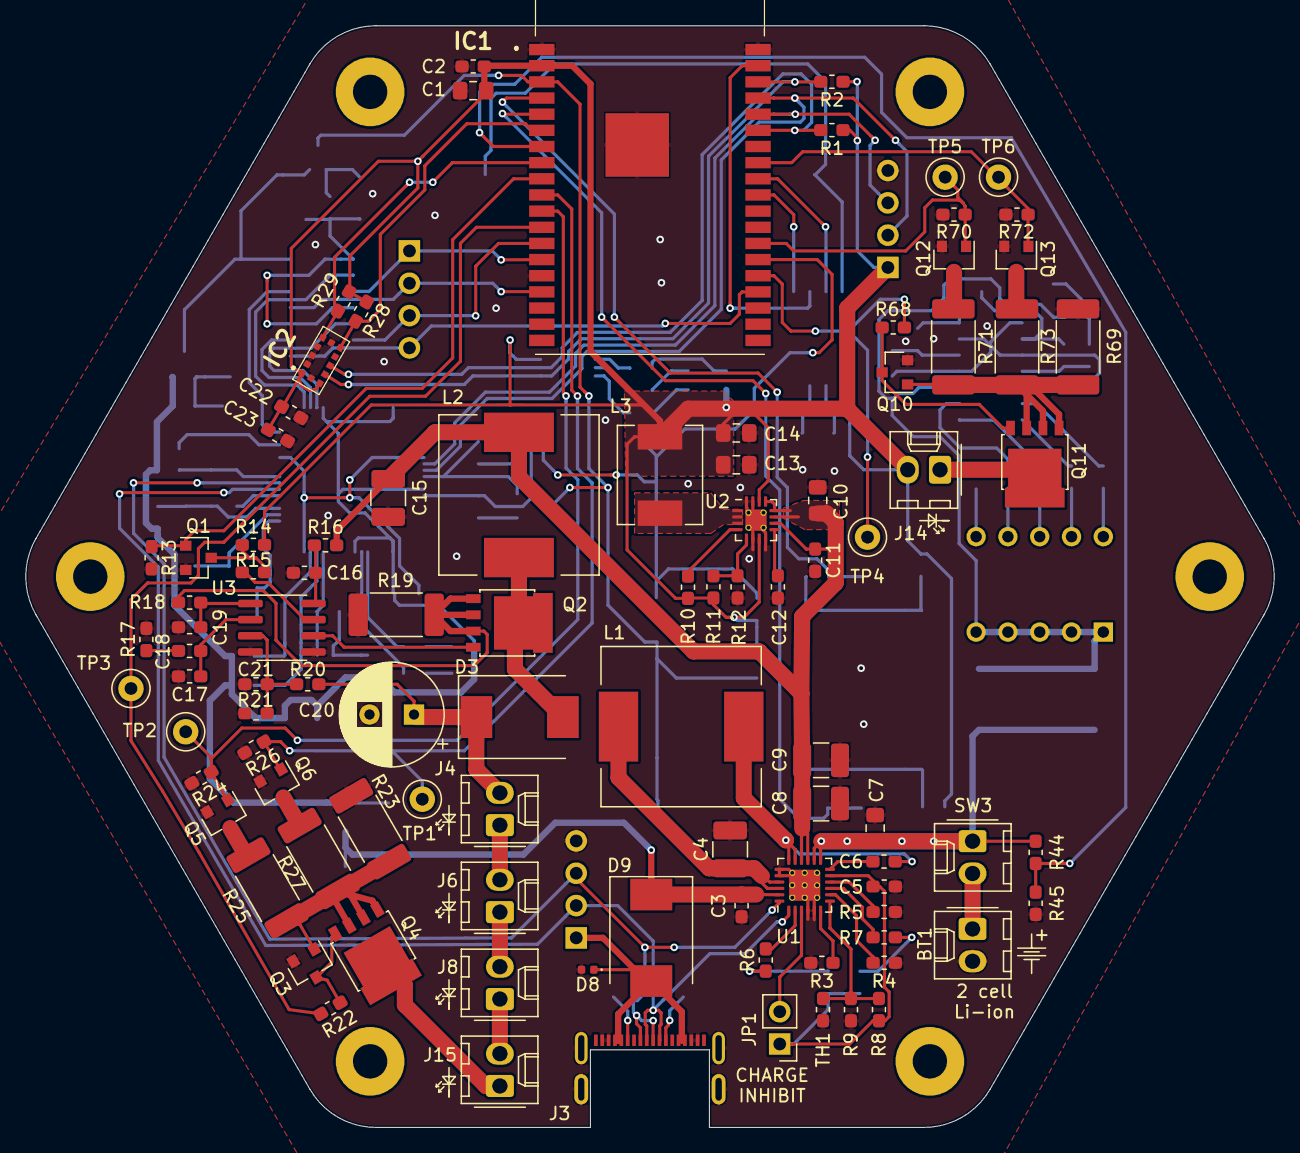
[picture p62: board sync_module.kicad_pcb from above]

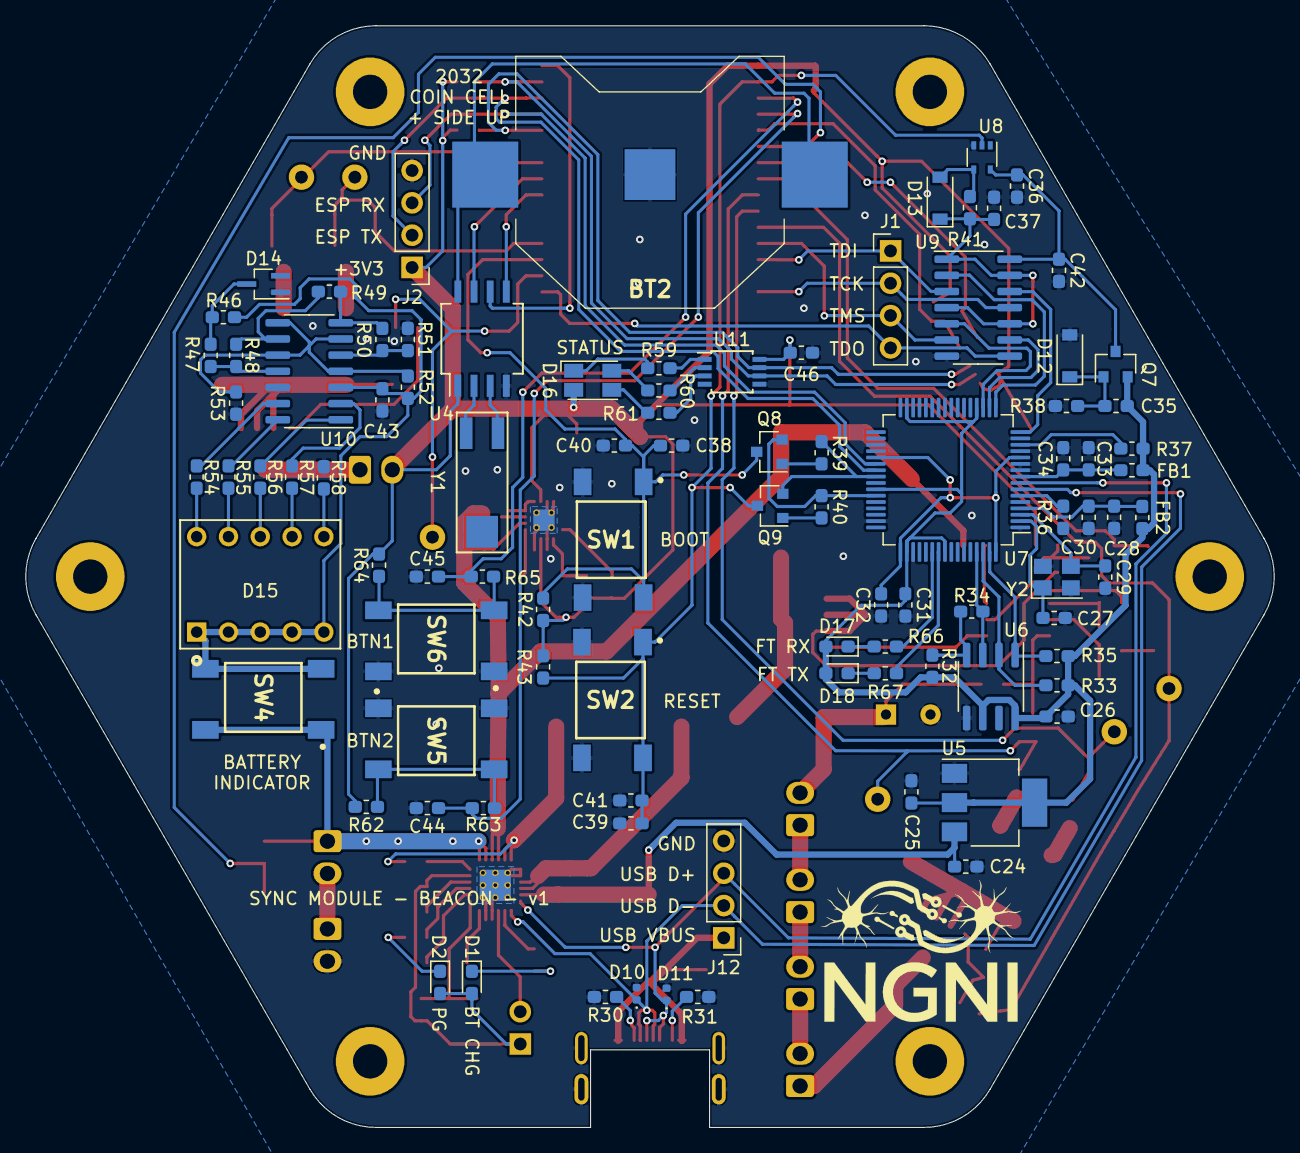
[picture p63: board sync_module.kicad_pcb from below]

Board: 2 copper layers, 98.1 x 86.6 mm, 198 parts (95 on the bottom side), 132 nets.

Other parts of the board:
D14: BZX84W-B4V3X; D_SOT-323_SC-70_ANK_Handsoldering
D15: LED_bar_5_pos; DC-05GWA_Kingbright_bar_graph_5_segment

Their connections:
GND: D14.2; also elsewhere on the board
unnamed 60: D15.1, D15.2, D15.3, D15.4, D15.5; also elsewhere on the board
unnamed 65: D14.1; also elsewhere on the board
unnamed 66: D15.6; also elsewhere on the board
unnamed 67: D15.7; also elsewhere on the board
unnamed 68: D15.8; also elsewhere on the board
unnamed 69: D15.9; also elsewhere on the board
unnamed 70: D15.10; also elsewhere on the board
